sturivny/co2_temperature_sensor_mac/requirements-cad.txt

# CAD generators: Python 3.12+
numpy==2.5.4
manifold3d==3.5.4
trimesh==5.1.1
matplotlib==3.11.2
Pillow==12.3.0
