sturivny/co2_temperature_sensor_mac/docs/ru/HARDWARE.md

# Аппаратная часть и корпус

## Соединение

Подтверждённая распайка: **GND → GND, VDD → 3V3, SDA → GPIO5, SCL → GPIO6**.
Провода припаяны прямо к контактам, без гребёнок. OLED и датчик используют одну
шину. OLED найден на 0x3C, датчик — на 0x62. Контроллер питается через USB-C.
Не подменять GPIO номерами контактов и не ориентироваться на поворот фотографии.

Заказ был на модуль SCD40; позднее продавец прислал описание SCD41. Прошивка
использует общий периодический режим SCD4x. Точная модификация и паспортная
точность конкретного экземпляра отдельно не подтверждены.

При первом запуске обнаружилась ошибка взаимодействия U8g2 и уже работающей
шины Wire. Она исправлена в 0.1.1: перед display.begin() выполняется Wire.end(),
после инициализации аппаратный I²C снова подключён к контактам. Повторное
обнаружение OLED выполняется через пять секунд, если при старте он не ответил.

## Фактические размеры

| Деталь | Размер |
|---|---|
| PCB контроллера | 24,8 × 20,6 мм |
| Углы контроллера | приближённо срез 1 × 1 мм под 45° |
| PCB датчика | 22,2 × 13 мм |
| Толщина текстолита | 1,5 мм |
| Общая высота датчика | 8 мм |
| Общая высота контроллера по замеру | 4 мм |
| Выступ USB-C за PCB | 2 мм |
| Металл USB-C | 9 × 3 мм |
| Низ металла относительно низа PCB | 1,1 мм |
| Винты v0.9 | M2 × 10 мм из-под головки, внутренний шестигранник, головка снаружи |

Корпус v0.9: **78 × 40 × 17 мм**, углы R3, кромки R0,6, стенки/дно/крышка 2 мм.
Окно USB-C: капсула 9,6 × 3,6 мм, R1,8. Разъём рассчитан заподлицо с внешней
стенкой; опоры держат прямые участки PCB и не опираются на срезанные углы.
В крышке прямые отверстия Ø2,4 мм и плоская посадка под головки M2 с внутренним
шестигранником, без зенковки. Для M2×10 длина считается из-под головки.
Защёлки есть на пробных образцах; в полном корпусе плату удерживают опоры
и выступы крышки. Батарея и SD-карта не предусмотрены.

Пользователь подтвердил идеальную посадку последнего образца и начал печатать
полный корпус. Полная проверка температуры в закрытом корпусе, всех кабелей,
долговечности защёлок и конкретного power bank не проводилась.

Файлы печати и подробные инструкции: [enclosure/v0.8](ENCLOSURE-v09.md).

## Ориентиры по CO₂

Прибор измеряет CO₂, а не кислород. Для домашней вентиляции ориентир:
до 1000 ppm — хороший уровень; 1000–1500 — стоит проветрить;
1500–2000 — вентиляции недостаточно; выше 2000 — усилить проветривание.
Это ориентиры воздухообмена, а не границы отравления и не оценка всех загрязнений.
Смотреть на тенденцию, держать прибор дальше 0,5 м от лица и не прямо у окна.

Источники: [UBA](https://www.umweltbundesamt.de/sites/default/files/medien/pdfs/kohlendioxid_2008.pdf),
[HSE](https://www.hse.gov.uk/ventilation/using-co2-monitors.htm).
Протокол датчика: [Sensirion SCD4x datasheet](https://admin.sensirion.com/media/documents/48C4B7FB/64C134E7/Sensirion_SCD4x_Datasheet.pdf).
