sturivny/co2_temperature_sensor_mac/docs/ru/ENCLOSURE-v09.md

# Корпус v0.9 — усиленный упор, открытый паз и обычные винты

[English](../../enclosure/v0.9/README.md) · [Предыдущая версия v0.8](ENCLOSURE.md)

Что изменилось

## Изменения

Задний упор контроллера, который сломался при использовании, заменён широкой
стенкой **3,2 × 8 мм** вместо 1,65 × 4 мм. Добавлены опорная площадка **10 × 10 мм**,
соединённая с дном, и два косых ребра длиной **6 мм**, толщиной **1,8 мм**.
Рёбра заканчиваются до перегородки и не перекрывают канал проводов.
Положение контактной поверхности сохранено: зазор до платы **0,15 мм**.
Это усиление геометрии; реальную прочность и ресурс проверяем печатью.

В перегородке сделан **паз шириной 8 мм, открытый сверху до дна**. Теперь можно
припаять провода к обеим платам снаружи корпуса, установить платы и опустить
провода в паз. Продевать их через нижнее отверстие не требуется.
При закрывании не зажимать провода опорами плат или крышкой.

В крышке **прямые отверстия Ø2,4 мм и плоские площадки** под обычные винты M2
с внутренним шестигранником. Зенковки и углубления под головку нет: головки
остаются снаружи, их высота добавляется к высоте корпуса **17 мм**.
Для M2×10 длина **10 мм считается из-под головки**. При этой длине до дна
пилотного отверстия остаётся около 2 мм. Отверстия в стойках Ø1,7 мм остались
под ввинчивание в пластик. Реальную резьбу сначала проверить на образце винта.

## Что печатать

Файлы находятся в `enclosure/v0.9/`:

- **`base.stl` и `lid.stl`** — новые основание и крышка. Собранный корпус
  без головок винтов: **78 × 40 × 17 мм**. Для этой версии использовать оба файла.
- **`fit_esp32_snaps.stl`** — сначала проверить держатель контроллера:
  **37,8 × 24,6 × 15 мм**, с усиленным упором, защёлками и USB-стенкой.
- `fit_esp32.stl` — тот же образец без боковых защёлок.
- `screw_test_base.stl` и `screw_test_cap.stl` — маленькая проба винта и плоской посадки.
- Образцы датчика не изменились относительно v0.8; перепечатывать их не нужно.

Масштаб 100%, миллиметры. Основание и образцы печатать дном на стол.
Крышка в STL уже перевёрнута плоской внешней стороной на стол.
Начальные настройки: сопло 0,4 мм, слой 0,2 мм, четыре периметра, шесть нижних
слоёв. Не забивать поддержками прорези защёлок. Материал, межслойное сцепление,
усилие винта и долговечность требуют физической проверки.

Размеры плат, высота корпуса, окно экрана и положение USB сохранены.
В полном корпусе платы удерживаются опорами и выступами крышки; боковые защёлки
есть только на пробных образцах. Изгиб проводов и высота головок не моделировались.

## Проверки

Восемь STL повторно открыты: замкнутые сетки, согласованные грани, одно связное
тело. Проверены посадка плат, их установка сверху, снятие крышки, отсутствие
пересечений с принятыми габаритами компонентов, капсульное окно USB, плоская
посадка головок и открытый сверху проводной паз. Образцы датчика побайтно
совпадают с v0.8. Единственное удаление материала основания — открытие паза.

Площадь сечения упора возле дна увеличилась с 6,6 до 100 мм² благодаря площадке;
это **не коэффициент увеличения прочности**. Нагрузочные испытания и расчёт
на усталость не проводились. Сначала проверить новый держатель на печати.
Исходники и команды сборки: [English guide](../../enclosure/v0.9/README.md).
