sturivny/co2_temperature_sensor_mac/docs/ru/ENCLOSURE.md

# Корпус CO₂ — v0.8: контроллер у USB-стенки, опоры на прямых краях

## Исправления после реальной примерки

Пользователь сообщил: образец датчика подошёл идеально; у контроллера опоры не учитывали форму углов, а USB был слишком утоплен. Новый замер длины контроллера — **24,8 мм**, ширина остаётся **20,6 мм**. На фото углы скруглены, пользователь описал их примерно как срез 1 × 1 мм под 45°. Точный радиус не измерен.

В v0.8:

- Контроллер задан как 24,8 × 20,6 мм. Для изображения и проверки принят срез углов 1 × 1 мм; это приближение, не точный радиус с фотографии.
- Четыре нижние опоры перенесены под прямые длинные края. Начало площадок — в 2 мм от торцов, длина каждой 2 мм, заход под текстолит 0,8 мм. Уголки платы больше не являются опорными точками.
- Убраны продольные выступы упоров перед USB. Текстолит со стороны USB прилегает к внутренней поверхности стенки. Сзади есть отдельный упор посередине прямого торца, с зазором 0,15 мм.
- Внутренняя стенка корпуса расположена на x=76 мм, край PCB тоже на x=76 мм. Разъём выступает на 2 мм и заканчивается на внешней поверхности корпуса x=78 мм: **номинальное утопление USB равно нулю**. В пробном образце использована та же геометрия.
- Вместе с платой сдвинуты ответные выступы крышки и окно OLED. Боковые защёлки в пробном образце сохранены.
- Крепление датчика не менялось. Оба STL образца датчика побайтно совпадают с v0.7 — повторно печатать их не требуется.
- Крышка и стойки адаптированы к пользовательским винтам **2 × 10 мм с конусной головкой Ø4,6 мм**.

## Что печатать сначала

**`fit_esp32_snaps.stl` — новый образец контроллера с защёлками и USB-стенкой.** Его габарит 28,8 × 24,6 × 15 мм. Для проверки нового расположения платы достаточно этого файла. Не использовать старый образец v0.7.

При установке сориентировать USB к стенке, развести защёлки, опустить PCB на четыре площадки. Передний край текстолита должен подходить непосредственно к внутренней поверхности USB-стенки. После отпускания защёлок плата должна держаться без давления на экран или разъём. Проверить, что пластиковые опоры не попали под припой или отдельные компоненты. Они расположены на прямых краях, но точное положение всех элементов с фото не моделировалось.

Подключить реальный кабель и проверить полную посадку. В проекте убрано утопление разъёма; подтвердить это необходимо на печати. Если пластик мешает, не изгибать плату и не проталкивать штекер силой. Для снятия развести защёлки и поднять плату за текстолит.

Второй вариант `fit_esp32.stl` — те же новые нижние опоры и стенка, но без боковых защёлок.

## Размеры и форма корпуса

Полный корпус **78 × 40 × 17 мм**. Углы R3 мм, наружные горизонтальные кромки R0,6 мм. Дно 2 мм, нижняя поверхность PCB на высоте 5 мм, текстолит 1,5 мм. Крышка 2 мм, над принятым габаритом датчика остаётся 2 мм.

Окно USB-C — капсула **9,6 × 3,6 мм, концы R1,8 мм**. Размер металла — пользовательский 9 × 3 мм, зазор по контуру 0,3 мм. Нижний край металла на 1,1 мм выше нижней поверхности PCB: металл занимает высоты 6,1–9,1 мм, окно — 5,8–9,4 мм. Вертикальное положение окна сохранено, изменена только глубина установки платы. Стандартный профиль сверялся с USB-IF Figure 3-1; точная каталожная модель разъёма неизвестна.

Датчик: PCB 22,2 × 13 мм, общая высота 8 мм, металлическая часть 8 × 8 мм. Размеры и положение датчика сохранены. Высота контроллера и положения стекла взяты из прежних замеров; стекло 12 × 12 мм. Провода припаиваются прямо, гребёнки не устанавливаются. Батарея и SD не предусмотрены; питание от power bank, журнал планируется во flash ESP32 с выгрузкой на Mac. Прошивка и приложение реализованы в корне репозитория; см. основной README.

## Винты и зенковка

Приняты винты диаметром 2 мм, **полной длиной 10 мм вместе с потайной головкой**, диаметр головки 4,6 мм. Угол конуса принят **90°**, пользователь его не измерял. Зенковка в крышке имеет диаметр 4,8 мм, сквозное отверстие 2,4 мм. Конус глубиной 1,2 мм оставляет 0,8 мм материала до нижней поверхности крышки вокруг сквозного отверстия.

Пилотные отверстия в стойках: диаметр 1,7 мм, глубина 10 мм. При принятой геометрии головка садится примерно на 0,1 мм ниже поверхности крышки; между концом винта и дном пилотного отверстия остаётся около 1,9 мм. Расчёт основан на длине 10 мм включая головку и конусе 90°.

**Сначала проверить винт:** напечатать `screw_test_base.stl` и `screw_test_cap.stl`. Установить маленькую крышку на блок и вкрутить один свой винт вручную. Проверить, что конус садится, головка не торчит и винт стягивает детали, не раскалывая пластик и не упираясь в дно. Этот тест не требует электроники. Если 10 мм измерены без головки или конус отличается от 90°, длину отверстий/зенковку надо скорректировать по фактическому винту.

Отверстие 1,7 мм предполагает ввинчивание в пластик. Тип резьбы винта не установлен, гайки и резьбовые вставки не предусмотрены. Усилие и пригодность резьбы подтверждает только маленький тест. При заметном сопротивлении не затягивать сильнее, чтобы не сломать стойку.

## Печать

Масштаб 100%, миллиметры. Основание/образцы — дном на стол; крышка корпуса в STL уже перевёрнута для печати плоской внешней стороной на стол. Крышку образца винта печатать плоской нижней стороной на стол.

Стартовые настройки: сопло 0,4 мм, слой 0,2 мм, 3 периметра. Для защёлок предпочтителен PETG; PLA — для осторожной первичной примерки. Не заполнять поддержкой прорези гибких защёлок. Проверить в слайсере тонкие стенки, скосы и мост над USB. После печати прорези должны быть свободны, без слипания первого слоя.

Боковые защёлки по-прежнему находятся **только на пробных образцах**. В полном корпусе нижние опоры работают вместе с удерживающими выступами крышки. Их новые места также перенесены на прямые края. Провода и припой не должны попадать под опорные площадки и концы выступов.

## Файлы

- `fit_esp32_snaps.stl` — рекомендуемый новый образец контроллера.
- `fit_esp32.stl` — новый образец без защёлок.
- `base.stl`, `lid.stl` — обновлённый корпус, основание 78 × 40 × 15 мм, крышка в положении для печати 78 × 40 × 10,1 мм; суммарная высота корпуса 17 мм.
- `fit_sensor_snaps.stl`, `fit_sensor.stl` — сохранённые образцы датчика, перепечатывать не требуется.
- `screw_test_base.stl` — блок для винта 14 × 14 × 12 мм; `screw_test_cap.stl` — крышка с зенковкой 14 × 14 × 2 мм.
- `enclosure.scad`, SCAD образцов, `screw_test.scad` — геометрические исходники.
- `preview_controller.png` — образец контроллера пустой и с условной моделью платы; `preview.png` — корпус из STL; `preview_samples.png` — оба образца.
- `build_enclosure.py`, `build_samples.py`, `build_fastener_test.py` — генераторы (Python, numpy, manifold3d, trimesh, matplotlib, Pillow). STL созданы напрямую геометрическим ядром; SCAD отдельно в OpenSCAD не компилировался.
- `validation*.json` — проверки; `check_mount.py`, `check_usb_profile.py` — дополнительные проверки посадки и USB-профиля. Проверка неизменности датчика использует сохранённые контрольные суммы; соседняя папка v0.7 не нужна.

## Проверки и границы подтверждения

Все восемь STL повторно открыты после экспорта: замкнутые поверхности, согласованные грани, по одному связному телу. Пересечений основания/крышки и принятых габаритов PCB/компонентов нет. Проверены вертикальная установка идеализированной PCB и снятие крышки.

Суммарная площадь опирания контроллера на прямые края — 6,4 мм². Она сохраняется при условных срезах углов 1, 1,5 и 2 мм и при скруглении R2 мм. Это показывает независимость опор от формы уголков в этом диапазоне. Положение всех деталей и припоя не моделировалось.

В образце и корпусе номинальный торец USB находится на наружной поверхности стенки. Сечение отверстия повторно проверено непосредственно в STL. Геометрия образцов датчика идентична уже примеренной версии, но электрические измерения и работа в закрытом корпусе ещё не проверены. Физическая посадка контроллера, кабеля и винтов, упругость защёлок, усадка печати и резьба в пластике остаются на этапе пробной печати.

## Текущее подтверждение

После v0.8 пользователь подтвердил идеальную посадку образца и начал печать корпуса.
Датчик, OLED, USB, журнал и Wi-Fi затем проверены отдельно; детали в VALIDATION.md.
Прежние оговорки о физической посадке выше описывают этап разработки и не заменяют
это подтверждение. Проверка измерений внутри полностью собранного корпуса ещё не проведена.

## Воспроизведение

Из корня репозитория после установки requirements-cad.txt:

```bash
.tooling/venv/bin/python enclosure/v0.8/build_enclosure.py
.tooling/venv/bin/python enclosure/v0.8/build_samples.py
.tooling/venv/bin/python enclosure/v0.8/build_fastener_test.py
.tooling/venv/bin/python enclosure/v0.8/check_mount.py
.tooling/venv/bin/python enclosure/v0.8/check_usb_profile.py
```
