sturivny/co2_temperature_sensor_mac/enclosure/v0.9/preview_samples.png

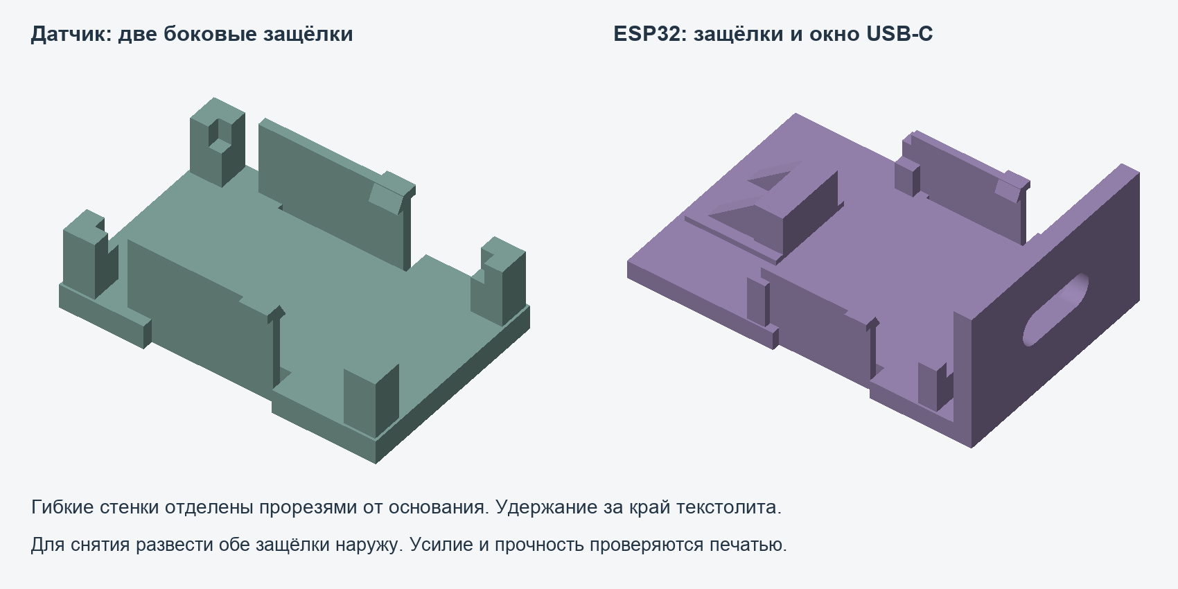
enclosure/v0.9/preview_samples.png
