sturivny/co2_temperature_sensor_mac/enclosure/v0.9/base.stl

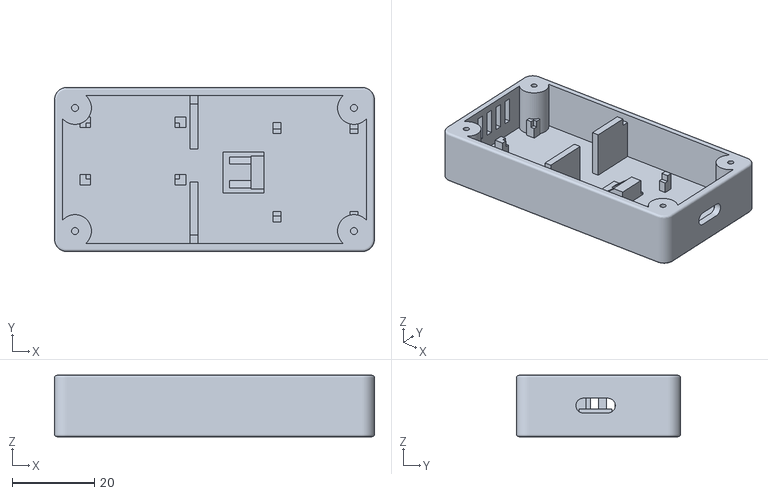
[picture p7: CAD file, 2026-10-28]
enclosure/v0.9/base.stl
78.0 x 40.0 x 15.0
