sturivny/co2_temperature_sensor_mac/enclosure/v0.9/fit_esp32_snaps.stl

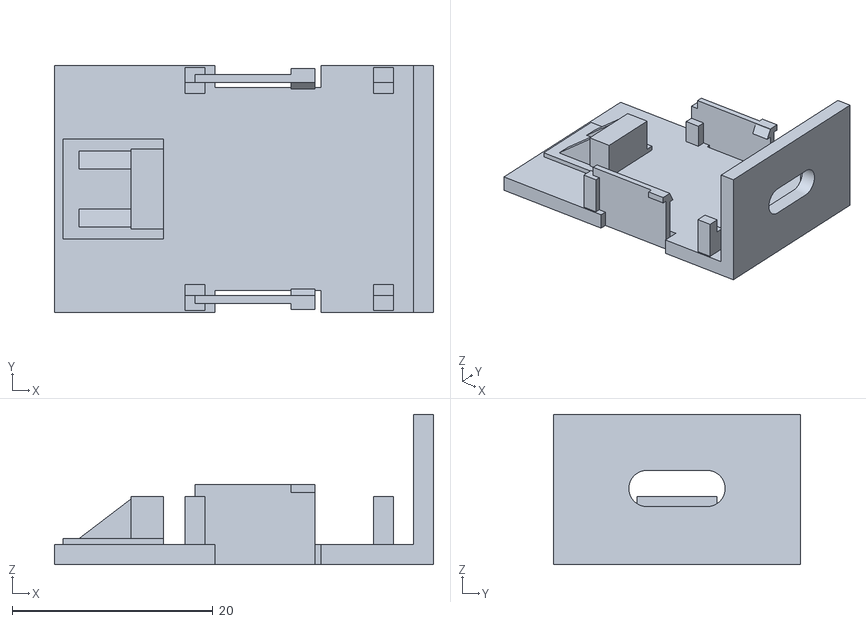
[picture p9: CAD file, 2026-10-28]
enclosure/v0.9/fit_esp32_snaps.stl
37.8 x 24.6 x 15.0
