sturivny/co2_temperature_sensor_mac/enclosure/v0.9/lid.stl

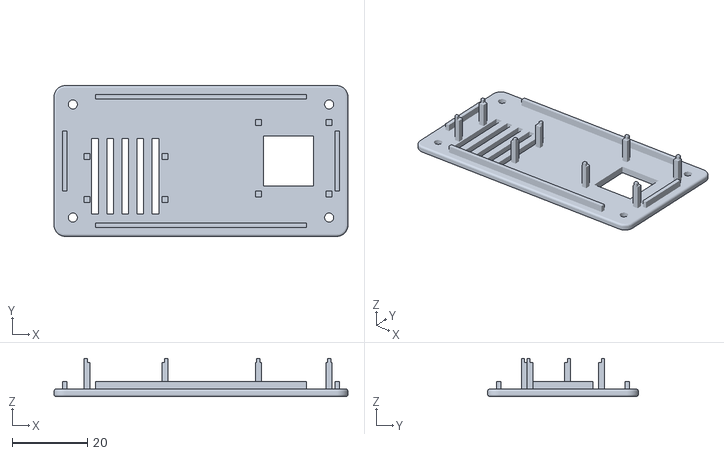
[picture p10: CAD file, 2026-10-28]
enclosure/v0.9/lid.stl
78.0 x 40.0 x 10.1
