sturivny/co2_temperature_sensor_mac/enclosure/v0.9/fit_sensor.stl

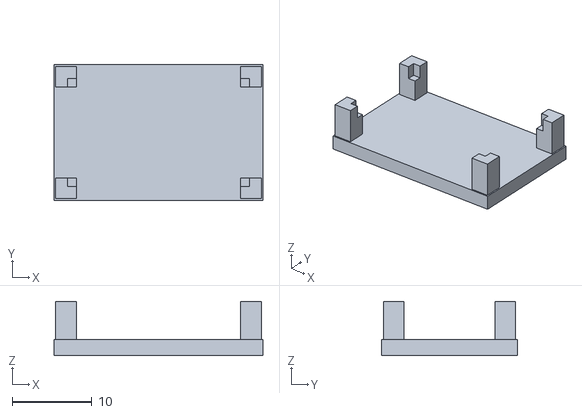
[picture p11: CAD file, 2026-10-16]
enclosure/v0.9/fit_sensor.stl
26.2 x 17.0 x 6.80
