sturivny/co2_temperature_sensor_mac/enclosure/v0.9/fit_sensor_snaps.stl

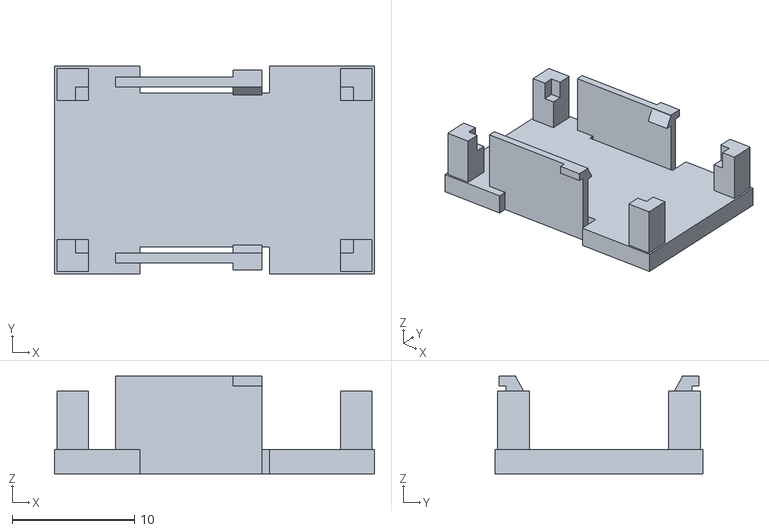
[picture p12: CAD file, 2026-10-16]
enclosure/v0.9/fit_sensor_snaps.stl
26.2 x 17.0 x 8.00
