sturivny/co2_temperature_sensor_mac/enclosure/v0.9/screw_test_cap.stl

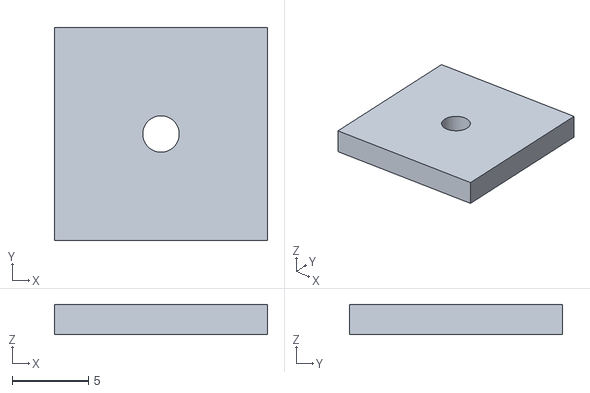
[picture p13: CAD file, 2026-10-28]
enclosure/v0.9/screw_test_cap.stl
14.0 x 14.0 x 2.00
