sturivny/co2_temperature_sensor_mac/enclosure/v0.9/screw_test_base.stl

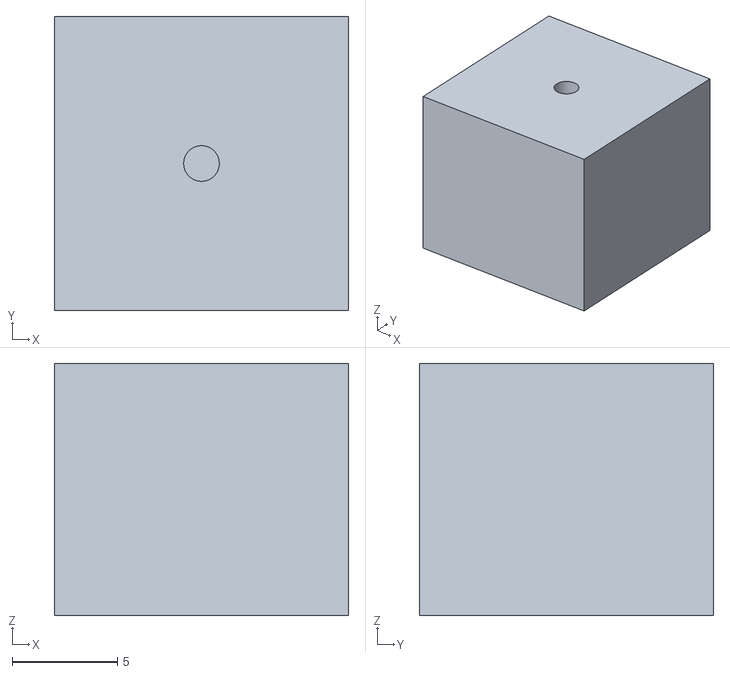
[picture p14: CAD file, 2026-10-16]
enclosure/v0.9/screw_test_base.stl
14.0 x 14.0 x 12.0
