sturivny/co2_temperature_sensor_mac/enclosure/v0.8/fit_esp32.stl

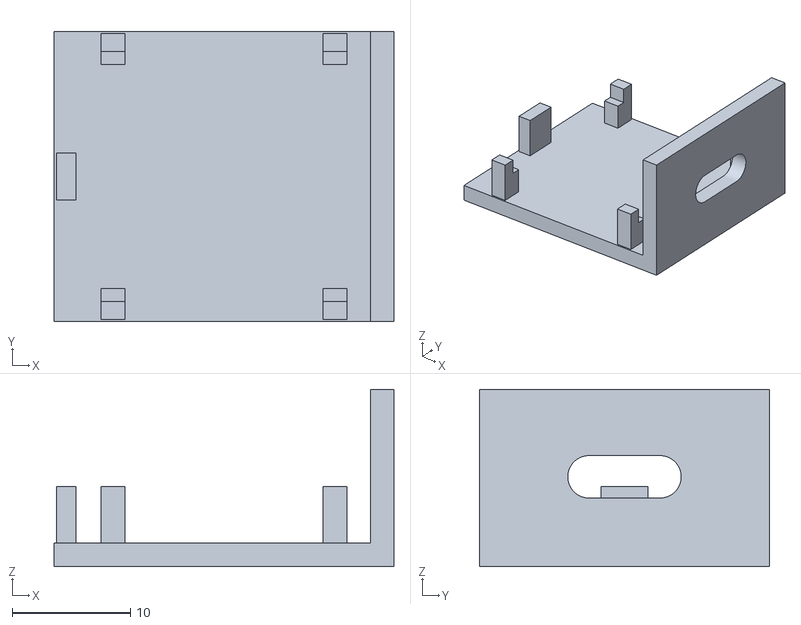
[picture p16: CAD file, 2026-10-16, an earlier design]
enclosure/v0.8/fit_esp32.stl
28.8 x 24.6 x 15.0
