sturivny/co2_temperature_sensor_mac/enclosure/v0.9/fit_sensor_snaps.scad

// Sample with flexible side latches, v0.9. Millimetres.
translate([-6.0, -16.0, 0]) union(){
difference(){
translate([6.0, 16.0, 0]) cube([26.2, 17.0, 2.0]);
translate([13.0, 15.9, -0.1]) cube([10.6, 2.3, 2.2]);
translate([13.0, 30.8, -0.1]) cube([10.6, 2.3, 2.2]);
}
union(){
translate([6.2, 16.2, 2.0]) cube([2.6, 2.6, 3.0]);
translate([6.2, 16.2, 2.0]) cube([1.5, 2.6, 4.8]);
translate([6.2, 16.2, 2.0]) cube([2.6, 1.5, 4.8]);
translate([6.2, 30.2, 2.0]) cube([2.6, 2.6, 3.0]);
translate([6.2, 30.2, 2.0]) cube([1.5, 2.6, 4.8]);
translate([6.2, 31.3, 2.0]) cube([2.6, 1.5, 4.8]);
translate([29.4, 16.2, 2.0]) cube([2.6, 2.6, 3.0]);
translate([30.5, 16.2, 2.0]) cube([1.5, 2.6, 4.8]);
translate([29.4, 16.2, 2.0]) cube([2.6, 1.5, 4.8]);
translate([29.4, 30.2, 2.0]) cube([2.6, 2.6, 3.0]);
translate([30.5, 30.2, 2.0]) cube([1.5, 2.6, 4.8]);
translate([29.4, 31.3, 2.0]) cube([2.6, 1.5, 4.8]);
}
union(){
translate([11.0, 16.9, 0]) cube([12.0, 0.8, 8.0]);
polyhedron(points=[[20.6, 18.35, 6.75], [23.0, 18.35, 6.75], [20.6, 17.65, 6.75], [23.0, 17.65, 6.75], [20.6, 17.65, 8.0], [23.0, 17.65, 8.0]],faces=[[0, 2, 4], [1, 5, 3], [0, 1, 3], [0, 3, 2], [2, 3, 5], [2, 5, 4], [4, 5, 1], [4, 1, 0]]);
translate([20.6, 16.299999999999997, 7.2]) cube([2.4, 0.65, 0.8]);
}
union(){
translate([11.0, 31.3, 0]) cube([12.0, 0.8, 8.0]);
polyhedron(points=[[20.6, 30.65, 6.75], [23.0, 30.65, 6.75], [20.6, 31.35, 6.75], [23.0, 31.35, 6.75], [20.6, 31.35, 8.0], [23.0, 31.35, 8.0]],faces=[[4, 2, 0], [3, 5, 1], [3, 1, 0], [2, 3, 0], [5, 3, 2], [4, 5, 2], [1, 5, 4], [0, 1, 4]]);
translate([20.6, 32.050000000000004, 7.2]) cube([2.4, 0.65, 0.8]);
}
}
