sturivny/co2_temperature_sensor_mac/enclosure/v0.9/enclosure.scad

// v0.9 measured boards; mm. Generated by build_enclosure.py.
// part: base / lid / assembly / exploded. STL lid is already oriented for printing.
part="exploded";
module base(){
difference(){
union(){
difference(){
polyhedron(points=[[77.4, 37.0, 0.0], [77.38844334401327, 37.23524113679095, 0.0], [77.35388467296775, 37.46821677283871, 0.0], [77.2966568057573, 37.69668322541071, 0.0], [77.21731087802709, 37.918440237676215, 0.0], [77.11661103443605, 38.13135216838239, 0.0], [76.9955270695261, 38.33336855924705, 0.0], [76.85522508807057, 38.522543881992746, 0.0], [76.69705627484771, 38.69705627484771, 0.0], [76.52254388199275, 38.85522508807057, 0.0], [76.33336855924705, 38.995527069526105, 0.0], [76.13135216838239, 39.116611034436055, 0.0], [75.91844023767622, 39.217310878027085, 0.0], [75.69668322541071, 39.2966568057573, 0.0], [75.4682167728387, 39.35388467296775, 0.0], [75.23524113679095, 39.388443344013275, 0.0], [75.0, 39.4, 0.0], [3.0, 39.4, 0.0], [2.7647588632090545, 39.388443344013275, 0.0], [2.5317832271612923, 39.35388467296775, 0.0], [2.30331677458929, 39.2966568057573, 0.0], [2.081559762323785, 39.217310878027085, 0.0], [1.8686478316176056, 39.116611034436055, 0.0], [1.6666314407529543, 38.995527069526105, 0.0], [1.4774561180072512, 38.85522508807057, 0.0], [1.3029437251522862, 38.69705627484771, 0.0], [1.1447749119294313, 38.522543881992746, 0.0], [1.0044729304738913, 38.33336855924705, 0.0], [0.8833889655639484, 38.13135216838239, 0.0], [0.7826891219729117, 37.918440237676215, 0.0], [0.7033431942426991, 37.69668322541071, 0.0], [0.646115327032247, 37.46821677283871, 0.0], [0.6115566559867278, 37.23524113679095, 0.0], [0.6000000000000001, 37.0, 0.0], [0.6000000000000001, 3.0000000000000004, 0.0], [0.6115566559867274, 2.7647588632090545, 0.0], [0.646115327032247, 2.531783227161292, 0.0], [0.7033431942426986, 2.303316774589291, 0.0], [0.7826891219729117, 2.081559762323785, 0.0], [0.883388965563948, 1.8686478316176056, 0.0], [1.0044729304738915, 1.6666314407529546, 0.0], [1.144774911929431, 1.4774561180072514, 0.0], [1.3029437251522855, 1.3029437251522862, 0.0], [1.47745611800725, 1.1447749119294321, 0.0], [1.6666314407529548, 1.0044729304738915, 0.0], [1.868647831617605, 0.8833889655639484, 0.0], [2.0815597623237854, 0.7826891219729117, 0.0], [2.30331677458929, 0.7033431942426991, 0.0], [2.5317832271612914, 0.6461153270322475, 0.0], [2.764758863209055, 0.6115566559867274, 0.0], [2.9999999999999996, 0.6000000000000001, 0.0], [75.0, 0.6000000000000001, 0.0], [75.23524113679095, 0.6115566559867274, 0.0], [75.4682167728387, 0.646115327032247, 0.0], [75.69668322541071, 0.7033431942426986, 0.0], [75.91844023767622, 0.7826891219729122, 0.0], [76.13135216838239, 0.883388965563948, 0.0], [76.33336855924705, 1.004472930473891, 0.0], [76.52254388199275, 1.1447749119294315, 0.0], [76.69705627484771, 1.3029437251522855, 0.0], [76.85522508807057, 1.4774561180072514, 0.0], [76.9955270695261, 1.6666314407529548, 0.0], [77.11661103443605, 1.868647831617605, 0.0], [77.21731087802709, 2.081559762323785, 0.0], [77.2966568057573, 2.30331677458929, 0.0], [77.35388467296775, 2.531783227161291, 0.0], [77.38844334401327, 2.764758863209055, 0.0], [77.4, 2.9999999999999996, 0.0], [77.55529142706152, 37.0, 0.020444504226559013], [77.54298700040802, 37.250462358389214, 0.020444504226559013], [77.5061922188025, 37.49851262735048, 0.020444504226559013], [77.44526143610588, 37.74176194719565, 0.020444504226559013], [77.3607814490637, 37.97786769400099, 0.020444504226559013], [77.2535658461326, 38.204556040356245, 0.020444504226559013], [77.12464717217885, 38.41964385356555, 0.020444504226559013], [76.97526698450673, 38.62105972040876, 0.020444504226559013], [76.80686389598304, 38.80686389598304, 0.020444504226559013], [76.62105972040877, 38.97526698450673, 0.020444504226559013], [76.41964385356556, 39.124647172178854, 0.020444504226559013], [76.20455604035624, 39.2535658461326, 0.020444504226559013], [75.97786769400099, 39.36078144906369, 0.020444504226559013], [75.74176194719564, 39.44526143610588, 0.020444504226559013], [75.49851262735048, 39.5061922188025, 0.020444504226559013], [75.25046235838921, 39.54298700040802, 0.020444504226559013], [75.0, 39.55529142706151, 0.020444504226559013], [3.0, 39.55529142706151, 0.020444504226559013], [2.7495376416107886, 39.54298700040802, 0.020444504226559013], [2.501487372649518, 39.5061922188025, 0.020444504226559013], [2.258238052804354, 39.44526143610588, 0.020444504226559013], [2.022132305999012, 39.36078144906369, 0.020444504226559013], [1.7954439596437561, 39.2535658461326, 0.020444504226559013], [1.5803561464344433, 39.124647172178854, 0.020444504226559013], [1.378940279591239, 38.97526698450673, 0.020444504226559013], [1.1931361040169546, 38.80686389598304, 0.020444504226559013], [1.0247330154932652, 38.62105972040876, 0.020444504226559013], [0.8753528278211467, 38.41964385356555, 0.020444504226559013], [0.7464341538673986, 38.204556040356245, 0.020444504226559013], [0.6392185509363113, 37.97786769400099, 0.020444504226559013], [0.5547385638941216, 37.74176194719565, 0.020444504226559013], [0.4938077811975039, 37.49851262735048, 0.020444504226559013], [0.45701299959198094, 37.250462358389214, 0.020444504226559013], [0.44470857293848765, 37.0, 0.020444504226559013], [0.44470857293848765, 3.0000000000000004, 0.020444504226559013], [0.45701299959198094, 2.7495376416107886, 0.020444504226559013], [0.4938077811975039, 2.5014873726495175, 0.020444504226559013], [0.5547385638941211, 2.258238052804355, 0.020444504226559013], [0.6392185509363109, 2.0221323059990124, 0.020444504226559013], [0.7464341538673986, 1.7954439596437564, 0.020444504226559013], [0.8753528278211467, 1.5803561464344436, 0.020444504226559013], [1.0247330154932648, 1.3789402795912393, 0.020444504226559013], [1.193136104016954, 1.1931361040169546, 0.020444504226559013], [1.378940279591238, 1.024733015493266, 0.020444504226559013], [1.5803561464344438, 0.8753528278211467, 0.020444504226559013], [1.7954439596437557, 0.7464341538673986, 0.020444504226559013], [2.022132305999013, 0.6392185509363109, 0.020444504226559013], [2.258238052804354, 0.5547385638941216, 0.020444504226559013], [2.5014873726495166, 0.4938077811975039, 0.020444504226559013], [2.749537641610789, 0.45701299959198094, 0.020444504226559013], [2.9999999999999996, 0.44470857293848765, 0.020444504226559013], [75.0, 0.44470857293848765, 0.020444504226559013], [75.25046235838921, 0.45701299959198094, 0.020444504226559013], [75.49851262735048, 0.4938077811975039, 0.020444504226559013], [75.74176194719564, 0.5547385638941211, 0.020444504226559013], [75.97786769400099, 0.6392185509363113, 0.020444504226559013], [76.20455604035624, 0.7464341538673986, 0.020444504226559013], [76.41964385356556, 0.8753528278211462, 0.020444504226559013], [76.62105972040877, 1.0247330154932655, 0.020444504226559013], [76.80686389598304, 1.193136104016954, 0.020444504226559013], [76.97526698450673, 1.3789402795912393, 0.020444504226559013], [77.12464717217885, 1.5803561464344438, 0.020444504226559013], [77.2535658461326, 1.7954439596437555, 0.020444504226559013], [77.3607814490637, 2.0221323059990124, 0.020444504226559013], [77.44526143610588, 2.258238052804354, 0.020444504226559013], [77.5061922188025, 2.5014873726495166, 0.020444504226559013], [77.54298700040802, 2.7495376416107886, 0.020444504226559013], [77.55529142706152, 2.9999999999999996, 0.020444504226559013], [77.7, 37.0, 0.08038475772933677], [77.68699876201494, 37.26464627888981, 0.08038475772933677], [77.64812025708872, 37.52674386944355, 0.08038475772933677], [77.58373890647697, 37.78376862858705, 0.08038475772933677], [77.49447473778048, 38.033245267385745, 0.08038475772933677], [77.38118741374056, 38.272771189430195, 0.08038475772933677], [77.24496795321687, 38.50003962915292, 0.08038475772933677], [77.0871282240794, 38.71286186724184, 0.08038475772933677], [76.90918830920369, 38.90918830920368, 0.08038475772933677], [76.71286186724184, 39.08712822407939, 0.08038475772933677], [76.50003962915292, 39.24496795321687, 0.08038475772933677], [76.27277118943019, 39.38118741374056, 0.08038475772933677], [76.03324526738574, 39.49447473778047, 0.08038475772933677], [75.78376862858705, 39.58373890647697, 0.08038475772933677], [75.52674386944355, 39.64812025708872, 0.08038475772933677], [75.26464627888981, 39.68699876201493, 0.08038475772933677], [75.0, 39.7, 0.08038475772933677], [3.0, 39.7, 0.08038475772933677], [2.735353721110186, 39.68699876201493, 0.08038475772933677], [2.4732561305564538, 39.64812025708872, 0.08038475772933677], [2.2162313714129516, 39.58373890647697, 0.08038475772933677], [1.9667547326142576, 39.49447473778047, 0.08038475772933677], [1.7272288105698061, 39.38118741374056, 0.08038475772933677], [1.4999603708470735, 39.24496795321687, 0.08038475772933677], [1.2871381327581575, 39.08712822407939, 0.08038475772933677], [1.0908116907963217, 38.90918830920368, 0.08038475772933677], [0.91287177592061, 38.71286186724184, 0.08038475772933677], [0.7550320467831275, 38.50003962915292, 0.08038475772933677], [0.6188125862594416, 38.272771189430195, 0.08038475772933677], [0.5055252622195257, 38.033245267385745, 0.08038475772933677], [0.416261093523036, 37.78376862858705, 0.08038475772933677], [0.35187974291127766, 37.52674386944354, 0.08038475772933677], [0.3130012379850684, 37.26464627888981, 0.08038475772933677], [0.2999999999999998, 37.0, 0.08038475772933677], [0.2999999999999998, 3.0000000000000004, 0.08038475772933677], [0.31300123798506796, 2.7353537211101866, 0.08038475772933677], [0.35187974291127766, 2.4732561305564533, 0.08038475772933677], [0.41626109352303553, 2.2162313714129525, 0.08038475772933677], [0.5055252622195252, 1.9667547326142578, 0.08038475772933677], [0.6188125862594411, 1.7272288105698064, 0.08038475772933677], [0.7550320467831275, 1.4999603708470737, 0.08038475772933677], [0.9128717759206095, 1.2871381327581577, 0.08038475772933677], [1.0908116907963212, 1.0908116907963217, 0.08038475772933677], [1.2871381327581561, 0.9128717759206109, 0.08038475772933677], [1.4999603708470741, 0.7550320467831275, 0.08038475772933677], [1.7272288105698055, 0.6188125862594416, 0.08038475772933677], [1.9667547326142583, 0.5055252622195252, 0.08038475772933677], [2.2162313714129516, 0.416261093523036, 0.08038475772933677], [2.4732561305564524, 0.3518797429112781, 0.08038475772933677], [2.7353537211101866, 0.31300123798506796, 0.08038475772933677], [2.9999999999999996, 0.2999999999999998, 0.08038475772933677], [75.0, 0.2999999999999998, 0.08038475772933677], [75.26464627888981, 0.31300123798506796, 0.08038475772933677], [75.52674386944355, 0.35187974291127766, 0.08038475772933677], [75.78376862858704, 0.41626109352303553, 0.08038475772933677], [76.03324526738574, 0.5055252622195261, 0.08038475772933677], [76.27277118943019, 0.6188125862594411, 0.08038475772933677], [76.50003962915292, 0.7550320467831271, 0.08038475772933677], [76.71286186724184, 0.9128717759206104, 0.08038475772933677], [76.90918830920367, 1.0908116907963212, 0.08038475772933677], [77.0871282240794, 1.2871381327581577, 0.08038475772933677], [77.24496795321687, 1.4999603708470741, 0.08038475772933677], [77.38118741374056, 1.7272288105698055, 0.08038475772933677], [77.49447473778048, 1.966754732614258, 0.08038475772933677], [77.58373890647697, 2.216231371412951, 0.08038475772933677], [77.64812025708872, 2.4732561305564524, 0.08038475772933677], [77.68699876201494, 2.7353537211101866, 0.08038475772933677], [77.7, 2.9999999999999996, 0.08038475772933677], [77.82426406871193, 37.0, 0.17573593128807144], [77.81066446527119, 37.276826287550676, 0.17573593128807144], [77.76999662656439, 37.550986586623594, 0.17573593128807144], [77.7026522061096, 37.819840583667414, 0.17573593128807144], [77.60927976749, 38.08079906772007, 0.17573593128807144], [77.49077853833205, 38.33134886592572, 0.17573593128807144], [77.34828975025192, 38.56907704676318, 0.17573593128807144], [77.18318564817109, 38.79169415789554, 0.17573593128807144], [76.99705627484771, 38.997056274847715, 0.17573593128807144], [76.79169415789553, 39.1831856481711, 0.17573593128807144], [76.56907704676317, 39.348289750251915, 0.17573593128807144], [76.33134886592572, 39.49077853833205, 0.17573593128807144], [76.08079906772008, 39.60927976749, 0.17573593128807144], [75.81984058366741, 39.702652206109605, 0.17573593128807144], [75.5509865866236, 39.7699966265644, 0.17573593128807144], [75.27682628755068, 39.81066446527119, 0.17573593128807144], [75.0, 39.824264068711926, 0.17573593128807144], [3.0, 39.824264068711926, 0.17573593128807144], [2.723173712449327, 39.81066446527119, 0.17573593128807144], [2.4490134133764094, 39.7699966265644, 0.17573593128807144], [2.1801594163325833, 39.702652206109605, 0.17573593128807144], [1.9192009322799255, 39.60927976749, 0.17573593128807144], [1.6686511340742816, 39.49077853833205, 0.17573593128807144], [1.4309229532368235, 39.348289750251915, 0.17573593128807144], [1.2083058421044603, 39.1831856481711, 0.17573593128807144], [1.0029437251522861, 38.997056274847715, 0.17573593128807144], [0.8168143518289042, 38.79169415789554, 0.17573593128807144], [0.6517102497480836, 38.56907704676318, 0.17573593128807144], [0.5092214616679467, 38.33134886592572, 0.17573593128807144], [0.39072023250999877, 38.08079906772007, 0.17573593128807144], [0.29734779389039323, 37.819840583667414, 0.17573593128807144], [0.23000337343560284, 37.55098658662359, 0.17573593128807144], [0.18933553472881304, 37.276826287550676, 0.17573593128807144], [0.17573593128807152, 37.0, 0.17573593128807144], [0.17573593128807152, 3.0000000000000004, 0.17573593128807144], [0.1893355347288126, 2.723173712449327, 0.17573593128807144], [0.23000337343560284, 2.449013413376409, 0.17573593128807144], [0.2973477938903928, 2.1801594163325837, 0.17573593128807144], [0.39072023250999877, 1.9192009322799257, 0.17573593128807144], [0.5092214616679467, 1.6686511340742818, 0.17573593128807144], [0.651710249748084, 1.430922953236824, 0.17573593128807144], [0.8168143518289037, 1.2083058421044606, 0.17573593128807144], [1.0029437251522855, 1.0029437251522861, 0.17573593128807144], [1.208305842104459, 0.816814351828905, 0.17573593128807144], [1.4309229532368242, 0.651710249748084, 0.17573593128807144], [1.668651134074281, 0.5092214616679467, 0.17573593128807144], [1.9192009322799262, 0.39072023250999877, 0.17573593128807144], [2.180159416332583, 0.29734779389039323, 0.17573593128807144], [2.449013413376408, 0.2300033734356033, 0.17573593128807144], [2.7231737124493276, 0.1893355347288126, 0.17573593128807144], [2.9999999999999996, 0.17573593128807152, 0.17573593128807144], [75.0, 0.17573593128807152, 0.17573593128807144], [75.27682628755068, 0.1893355347288126, 0.17573593128807144], [75.5509865866236, 0.23000337343560284, 0.17573593128807144], [75.81984058366741, 0.2973477938903928, 0.17573593128807144], [76.08079906772008, 0.3907202325099992, 0.17573593128807144], [76.33134886592572, 0.5092214616679467, 0.17573593128807144], [76.56907704676317, 0.6517102497480831, 0.17573593128807144], [76.79169415789553, 0.8168143518289042, 0.17573593128807144], [76.99705627484771, 1.0029437251522855, 0.17573593128807144], [77.18318564817109, 1.2083058421044606, 0.17573593128807144], [77.34828975025192, 1.4309229532368242, 0.17573593128807144], [77.49077853833205, 1.668651134074281, 0.17573593128807144], [77.60927976749, 1.9192009322799262, 0.17573593128807144], [77.7026522061096, 2.180159416332583, 0.17573593128807144], [77.76999662656439, 2.449013413376408, 0.17573593128807144], [77.81066446527119, 2.723173712449327, 0.17573593128807144], [77.82426406871193, 2.999999999999999, 0.17573593128807144], [77.91961524227067, 37.0, 0.29999999999999993], [77.9055564968671, 37.28617233690997, 0.29999999999999993], [77.86351565405998, 37.56958867777778, 0.29999999999999993], [77.79389759014737, 37.84751956830975, 0.29999999999999993], [77.69737276514185, 38.11728838209757, 0.29999999999999993], [77.57487076587407, 38.376297097993834, 0.29999999999999993], [77.4275713535634, 38.6220513204759, 0.29999999999999993], [77.2568931020724, 38.852184302038324, 0.29999999999999993], [77.06447973626518, 39.06447973626519, 0.29999999999999993], [76.85218430203832, 39.256893102072404, 0.29999999999999993], [76.62205132047589, 39.42757135356339, 0.29999999999999993], [76.37629709799384, 39.574870765874074, 0.29999999999999993], [76.11728838209757, 39.69737276514185, 0.29999999999999993], [75.84751956830975, 39.79389759014736, 0.29999999999999993], [75.56958867777779, 39.86351565405998, 0.29999999999999993], [75.28617233690997, 39.90555649686711, 0.29999999999999993], [75.0, 39.919615242270666, 0.29999999999999993], [3.0, 39.919615242270666, 0.29999999999999993], [2.713827663090032, 39.90555649686711, 0.29999999999999993], [2.43041132222222, 39.86351565405998, 0.29999999999999993], [2.1524804316902513, 39.79389759014736, 0.29999999999999993], [1.8827116179024295, 39.69737276514185, 0.29999999999999993], [1.6237029020061646, 39.574870765874074, 0.29999999999999993], [1.3779486795241047, 39.42757135356339, 0.29999999999999993], [1.1478156979616767, 39.256893102072404, 0.29999999999999993], [0.9355202637348095, 39.06447973626519, 0.29999999999999993], [0.7431068979275972, 38.852184302038324, 0.29999999999999993], [0.5724286464366095, 38.6220513204759, 0.29999999999999993], [0.42512923412592807, 38.376297097993834, 0.29999999999999993], [0.30262723485815224, 38.11728838209757, 0.29999999999999993], [0.20610240985263717, 37.84751956830975, 0.29999999999999993], [0.1364843459400218, 37.56958867777778, 0.29999999999999993], [0.09444350313289007, 37.28617233690997, 0.29999999999999993], [0.08038475772933662, 37.0, 0.29999999999999993], [0.08038475772933662, 3.0000000000000004, 0.29999999999999993], [0.09444350313288963, 2.7138276630900324, 0.29999999999999993], [0.1364843459400218, 2.43041132222222, 0.29999999999999993], [0.20610240985263673, 2.152480431690252, 0.29999999999999993], [0.30262723485815224, 1.8827116179024297, 0.29999999999999993], [0.4251292341259276, 1.6237029020061648, 0.29999999999999993], [0.57242864643661, 1.377948679524105, 0.29999999999999993], [0.7431068979275968, 1.147815697961677, 0.29999999999999993], [0.9355202637348086, 0.9355202637348095, 0.29999999999999993], [1.1478156979616754, 0.7431068979275981, 0.29999999999999993], [1.3779486795241054, 0.57242864643661, 0.29999999999999993], [1.623702902006164, 0.42512923412592807, 0.29999999999999993], [1.8827116179024301, 0.30262723485815224, 0.29999999999999993], [2.1524804316902513, 0.20610240985263717, 0.29999999999999993], [2.430411322222219, 0.13648434594002223, 0.29999999999999993], [2.713827663090033, 0.09444350313288963, 0.29999999999999993], [2.9999999999999996, 0.08038475772933662, 0.29999999999999993], [75.0, 0.08038475772933662, 0.29999999999999993], [75.28617233690997, 0.09444350313288963, 0.29999999999999993], [75.56958867777779, 0.1364843459400218, 0.29999999999999993], [75.84751956830975, 0.20610240985263673, 0.29999999999999993], [76.11728838209757, 0.3026272348581527, 0.29999999999999993], [76.37629709799384, 0.4251292341259276, 0.29999999999999993], [76.62205132047589, 0.5724286464366091, 0.29999999999999993], [76.85218430203832, 0.7431068979275977, 0.29999999999999993], [77.06447973626518, 0.9355202637348086, 0.29999999999999993], [77.2568931020724, 1.147815697961677, 0.29999999999999993], [77.4275713535634, 1.3779486795241054, 0.29999999999999993], [77.57487076587407, 1.6237029020061637, 0.29999999999999993], [77.69737276514185, 1.88271161790243, 0.29999999999999993], [77.79389759014737, 2.1524804316902513, 0.29999999999999993], [77.86351565405998, 2.4304113222222186, 0.29999999999999993], [77.9055564968671, 2.7138276630900324, 0.29999999999999993], [77.91961524227067, 2.999999999999999, 0.29999999999999993], [77.97955549577344, 37.0, 0.4447085729384874], [77.96520812166594, 37.29204750914894, 0.4447085729384874], [77.92230417239914, 37.581282441135365, 0.4447085729384874], [77.85125683645819, 37.864919305452354, 0.4447085729384874], [77.7527503385266, 38.14022652404485, 0.4447085729384874], [77.6277333500286, 38.404552737899564, 0.4447085729384874], [77.47740985290466, 38.65535234108169, 0.4447085729384874], [77.30322754460727, 38.890209996311555, 0.4447085729384874], [77.10686389598304, 39.10686389598305, 0.4447085729384874], [76.89020999631155, 39.30322754460726, 0.4447085729384874], [76.65535234108168, 39.477409852904664, 0.4447085729384874], [76.40455273789956, 39.627733350028606, 0.4447085729384874], [76.14022652404485, 39.7527503385266, 0.4447085729384874], [75.86491930545235, 39.851256836458184, 0.4447085729384874], [75.58128244113537, 39.92230417239914, 0.4447085729384874], [75.29204750914894, 39.96520812166593, 0.4447085729384874], [75.0, 39.97955549577344, 0.4447085729384874], [3.0, 39.97955549577344, 0.4447085729384874], [2.707952490851061, 39.96520812166593, 0.4447085729384874], [2.418717558864635, 39.92230417239914, 0.4447085729384874], [2.1350806945476473, 39.851256836458184, 0.4447085729384874], [1.859773475955153, 39.7527503385266, 0.4447085729384874], [1.595447262100432, 39.627733350028606, 0.4447085729384874], [1.3446476589183125, 39.47740985290466, 0.4447085729384874], [1.1097900036884483, 39.30322754460726, 0.4447085729384874], [0.8931361040169548, 39.10686389598305, 0.4447085729384874], [0.6967724553927379, 38.890209996311555, 0.4447085729384874], [0.5225901470953387, 38.65535234108169, 0.4447085729384874], [0.37226664997139736, 38.40455273789957, 0.4447085729384874], [0.24724966147339833, 38.14022652404485, 0.4447085729384874], [0.14874316354181571, 37.864919305452354, 0.4447085729384874], [0.07769582760085969, 37.581282441135365, 0.4447085729384874], [0.03479187833406616, 37.29204750914894, 0.4447085729384874], [0.02044450422655908, 37.0, 0.4447085729384874], [0.02044450422655908, 3.0000000000000004, 0.4447085729384874], [0.03479187833406616, 2.7079524908510613, 0.4447085729384874], [0.07769582760085969, 2.4187175588646346, 0.4447085729384874], [0.14874316354181527, 2.1350806945476477, 0.4447085729384874], [0.24724966147339789, 1.8597734759551532, 0.4447085729384874], [0.3722666499713969, 1.5954472621004323, 0.4447085729384874], [0.5225901470953391, 1.3446476589183127, 0.4447085729384874], [0.6967724553927375, 1.1097900036884485, 0.4447085729384874], [0.8931361040169539, 0.8931361040169548, 0.4447085729384874], [1.109790003688447, 0.6967724553927388, 0.4447085729384874], [1.3446476589183132, 0.5225901470953391, 0.4447085729384874], [1.5954472621004314, 0.37226664997139736, 0.4447085729384874], [1.8597734759551536, 0.24724966147339789, 0.4447085729384874], [2.135080694547647, 0.14874316354181571, 0.4447085729384874], [2.4187175588646337, 0.07769582760085969, 0.4447085729384874], [2.7079524908510617, 0.03479187833406616, 0.4447085729384874], [2.9999999999999996, 0.02044450422655908, 0.4447085729384874], [75.0, 0.02044450422655908, 0.4447085729384874], [75.29204750914894, 0.03479187833406616, 0.4447085729384874], [75.58128244113537, 0.07769582760085969, 0.4447085729384874], [75.86491930545235, 0.14874316354181527, 0.4447085729384874], [76.14022652404485, 0.24724966147339833, 0.4447085729384874], [76.40455273789956, 0.3722666499713969, 0.4447085729384874], [76.65535234108168, 0.5225901470953382, 0.4447085729384874], [76.89020999631155, 0.6967724553927384, 0.4447085729384874], [77.10686389598304, 0.8931361040169539, 0.4447085729384874], [77.30322754460727, 1.1097900036884485, 0.4447085729384874], [77.47740985290466, 1.3446476589183132, 0.4447085729384874], [77.6277333500286, 1.5954472621004314, 0.4447085729384874], [77.7527503385266, 1.8597734759551536, 0.4447085729384874], [77.85125683645819, 2.135080694547647, 0.4447085729384874], [77.92230417239914, 2.4187175588646332, 0.4447085729384874], [77.96520812166594, 2.7079524908510613, 0.4447085729384874], [77.97955549577344, 2.999999999999999, 0.4447085729384874], [78.0, 37.0, 0.5999999999999999], [77.98555418001659, 37.29405142098868, 0.5999999999999999], [77.94235584120969, 37.585270966048384, 0.5999999999999999], [77.87082100719662, 37.870854031763386, 0.5999999999999999], [77.77163859753387, 38.14805029709527, 0.5999999999999999], [77.64576379304506, 38.41419021047799, 0.5999999999999999], [77.49440883690764, 38.666710699058804, 0.5999999999999999], [77.31903136008822, 38.903179852490936, 0.5999999999999999], [77.12132034355965, 39.121320343559645, 0.5999999999999999], [76.90317985249094, 39.31903136008821, 0.5999999999999999], [76.66671069905881, 39.49440883690764, 0.5999999999999999], [76.414190210478, 39.64576379304506, 0.5999999999999999], [76.14805029709527, 39.77163859753386, 0.5999999999999999], [75.87085403176339, 39.870821007196625, 0.5999999999999999], [75.58527096604838, 39.94235584120969, 0.5999999999999999], [75.29405142098868, 39.98555418001659, 0.5999999999999999], [75.0, 40.0, 0.5999999999999999], [3.0, 40.0, 0.5999999999999999], [2.7059485790113182, 39.98555418001659, 0.5999999999999999], [2.414729033951615, 39.94235584120969, 0.5999999999999999], [2.129145968236613, 39.870821007196625, 0.5999999999999999], [1.8519497029047307, 39.77163859753386, 0.5999999999999999], [1.585809789522007, 39.64576379304506, 0.5999999999999999], [1.3332893009411928, 39.49440883690764, 0.5999999999999999], [1.0968201475090638, 39.31903136008821, 0.5999999999999999], [0.8786796564403576, 39.121320343559645, 0.5999999999999999], [0.6809686399117889, 38.903179852490936, 0.5999999999999999], [0.505591163092364, 38.666710699058804, 0.5999999999999999], [0.3542362069549352, 38.41419021047799, 0.5999999999999999], [0.22836140246614, 38.14805029709527, 0.5999999999999999], [0.1291789928033733, 37.870854031763386, 0.5999999999999999], [0.05764415879030871, 37.585270966048384, 0.5999999999999999], [0.014445819983409436, 37.29405142098868, 0.5999999999999999], [0.0, 37.0, 0.5999999999999999], [0.0, 3.0000000000000004, 0.5999999999999999], [0.014445819983409436, 2.7059485790113182, 0.5999999999999999], [0.05764415879030871, 2.414729033951615, 0.5999999999999999], [0.1291789928033733, 2.129145968236614, 0.5999999999999999], [0.22836140246613956, 1.851949702904731, 0.5999999999999999], [0.35423620695493474, 1.5858097895220071, 0.5999999999999999], [0.5055911630923644, 1.333289300941193, 0.5999999999999999], [0.6809686399117885, 1.0968201475090642, 0.5999999999999999], [0.8786796564403572, 0.8786796564403576, 0.5999999999999999], [1.0968201475090624, 0.6809686399117902, 0.5999999999999999], [1.3332893009411935, 0.5055911630923644, 0.5999999999999999], [1.5858097895220062, 0.3542362069549352, 0.5999999999999999], [1.8519497029047316, 0.22836140246613956, 0.5999999999999999], [2.129145968236613, 0.1291789928033733, 0.5999999999999999], [2.414729033951614, 0.05764415879030915, 0.5999999999999999], [2.7059485790113187, 0.014445819983409436, 0.5999999999999999], [2.9999999999999996, 0.0, 0.5999999999999999], [75.0, 0.0, 0.5999999999999999], [75.29405142098868, 0.014445819983409436, 0.5999999999999999], [75.58527096604838, 0.05764415879030871, 0.5999999999999999], [75.87085403176339, 0.1291789928033733, 0.5999999999999999], [76.14805029709527, 0.22836140246614, 0.5999999999999999], [76.414190210478, 0.35423620695493474, 0.5999999999999999], [76.66671069905881, 0.5055911630923635, 0.5999999999999999], [76.90317985249094, 0.6809686399117894, 0.5999999999999999], [77.12132034355965, 0.8786796564403572, 0.5999999999999999], [77.31903136008822, 1.0968201475090642, 0.5999999999999999], [77.49440883690764, 1.3332893009411935, 0.5999999999999999], [77.64576379304506, 1.585809789522006, 0.5999999999999999], [77.77163859753387, 1.8519497029047314, 0.5999999999999999], [77.87082100719662, 2.1291459682366125, 0.5999999999999999], [77.94235584120969, 2.414729033951614, 0.5999999999999999], [77.98555418001659, 2.7059485790113182, 0.5999999999999999], [78.0, 2.999999999999999, 0.5999999999999999], [78.0, 37.0, 14.4], [77.98555418001659, 37.29405142098868, 14.4], [77.94235584120969, 37.585270966048384, 14.4], [77.87082100719662, 37.870854031763386, 14.4], [77.77163859753387, 38.14805029709527, 14.4], [77.64576379304506, 38.41419021047799, 14.4], [77.49440883690764, 38.666710699058804, 14.4], [77.31903136008822, 38.903179852490936, 14.4], [77.12132034355965, 39.121320343559645, 14.4], [76.90317985249094, 39.31903136008821, 14.4], [76.66671069905881, 39.49440883690764, 14.4], [76.414190210478, 39.64576379304506, 14.4], [76.14805029709527, 39.77163859753386, 14.4], [75.87085403176339, 39.870821007196625, 14.4], [75.58527096604838, 39.94235584120969, 14.4], [75.29405142098868, 39.98555418001659, 14.4], [75.0, 40.0, 14.4], [3.0, 40.0, 14.4], [2.7059485790113182, 39.98555418001659, 14.4], [2.414729033951615, 39.94235584120969, 14.4], [2.129145968236613, 39.870821007196625, 14.4], [1.8519497029047307, 39.77163859753386, 14.4], [1.585809789522007, 39.64576379304506, 14.4], [1.3332893009411928, 39.49440883690764, 14.4], [1.0968201475090638, 39.31903136008821, 14.4], [0.8786796564403576, 39.121320343559645, 14.4], [0.6809686399117889, 38.903179852490936, 14.4], [0.505591163092364, 38.666710699058804, 14.4], [0.3542362069549352, 38.41419021047799, 14.4], [0.22836140246614, 38.14805029709527, 14.4], [0.1291789928033733, 37.870854031763386, 14.4], [0.05764415879030871, 37.585270966048384, 14.4], [0.014445819983409436, 37.29405142098868, 14.4], [0.0, 37.0, 14.4], [0.0, 3.0000000000000004, 14.4], [0.014445819983409436, 2.7059485790113182, 14.4], [0.05764415879030871, 2.414729033951615, 14.4], [0.1291789928033733, 2.129145968236614, 14.4], [0.22836140246613956, 1.851949702904731, 14.4], [0.35423620695493474, 1.5858097895220071, 14.4], [0.5055911630923644, 1.333289300941193, 14.4], [0.6809686399117885, 1.0968201475090642, 14.4], [0.8786796564403572, 0.8786796564403576, 14.4], [1.0968201475090624, 0.6809686399117902, 14.4], [1.3332893009411935, 0.5055911630923644, 14.4], [1.5858097895220062, 0.3542362069549352, 14.4], [1.8519497029047316, 0.22836140246613956, 14.4], [2.129145968236613, 0.1291789928033733, 14.4], [2.414729033951614, 0.05764415879030915, 14.4], [2.7059485790113187, 0.014445819983409436, 14.4], [2.9999999999999996, 0.0, 14.4], [75.0, 0.0, 14.4], [75.29405142098868, 0.014445819983409436, 14.4], [75.58527096604838, 0.05764415879030871, 14.4], [75.87085403176339, 0.1291789928033733, 14.4], [76.14805029709527, 0.22836140246614, 14.4], [76.414190210478, 0.35423620695493474, 14.4], [76.66671069905881, 0.5055911630923635, 14.4], [76.90317985249094, 0.6809686399117894, 14.4], [77.12132034355965, 0.8786796564403572, 14.4], [77.31903136008822, 1.0968201475090642, 14.4], [77.49440883690764, 1.3332893009411935, 14.4], [77.64576379304506, 1.585809789522006, 14.4], [77.77163859753387, 1.8519497029047314, 14.4], [77.87082100719662, 2.1291459682366125, 14.4], [77.94235584120969, 2.414729033951614, 14.4], [77.98555418001659, 2.7059485790113182, 14.4], [78.0, 2.999999999999999, 14.4], [77.97955549577344, 37.0, 14.555291427061512], [77.96520812166594, 37.29204750914894, 14.555291427061512], [77.92230417239914, 37.581282441135365, 14.555291427061512], [77.85125683645819, 37.864919305452354, 14.555291427061512], [77.7527503385266, 38.14022652404485, 14.555291427061512], [77.6277333500286, 38.404552737899564, 14.555291427061512], [77.47740985290466, 38.65535234108169, 14.555291427061512], [77.30322754460727, 38.890209996311555, 14.555291427061512], [77.10686389598304, 39.10686389598305, 14.555291427061512], [76.89020999631155, 39.30322754460726, 14.555291427061512], [76.65535234108168, 39.477409852904664, 14.555291427061512], [76.40455273789956, 39.627733350028606, 14.555291427061512], [76.14022652404485, 39.7527503385266, 14.555291427061512], [75.86491930545235, 39.851256836458184, 14.555291427061512], [75.58128244113537, 39.92230417239914, 14.555291427061512], [75.29204750914894, 39.96520812166593, 14.555291427061512], [75.0, 39.97955549577344, 14.555291427061512], [3.0, 39.97955549577344, 14.555291427061512], [2.707952490851061, 39.96520812166593, 14.555291427061512], [2.418717558864635, 39.92230417239914, 14.555291427061512], [2.1350806945476473, 39.851256836458184, 14.555291427061512], [1.859773475955153, 39.7527503385266, 14.555291427061512], [1.595447262100432, 39.627733350028606, 14.555291427061512], [1.3446476589183125, 39.47740985290466, 14.555291427061512], [1.1097900036884483, 39.30322754460726, 14.555291427061512], [0.8931361040169548, 39.10686389598305, 14.555291427061512], [0.6967724553927379, 38.890209996311555, 14.555291427061512], [0.5225901470953387, 38.65535234108169, 14.555291427061512], [0.37226664997139736, 38.40455273789957, 14.555291427061512], [0.24724966147339833, 38.14022652404485, 14.555291427061512], [0.14874316354181571, 37.864919305452354, 14.555291427061512], [0.07769582760085969, 37.581282441135365, 14.555291427061512], [0.03479187833406616, 37.29204750914894, 14.555291427061512], [0.02044450422655908, 37.0, 14.555291427061512], [0.02044450422655908, 3.0000000000000004, 14.555291427061512], [0.03479187833406616, 2.7079524908510613, 14.555291427061512], [0.07769582760085969, 2.4187175588646346, 14.555291427061512], [0.14874316354181527, 2.1350806945476477, 14.555291427061512], [0.24724966147339789, 1.8597734759551532, 14.555291427061512], [0.3722666499713969, 1.5954472621004323, 14.555291427061512], [0.5225901470953391, 1.3446476589183127, 14.555291427061512], [0.6967724553927375, 1.1097900036884485, 14.555291427061512], [0.8931361040169539, 0.8931361040169548, 14.555291427061512], [1.109790003688447, 0.6967724553927388, 14.555291427061512], [1.3446476589183132, 0.5225901470953391, 14.555291427061512], [1.5954472621004314, 0.37226664997139736, 14.555291427061512], [1.8597734759551536, 0.24724966147339789, 14.555291427061512], [2.135080694547647, 0.14874316354181571, 14.555291427061512], [2.4187175588646337, 0.07769582760085969, 14.555291427061512], [2.7079524908510617, 0.03479187833406616, 14.555291427061512], [2.9999999999999996, 0.02044450422655908, 14.555291427061512], [75.0, 0.02044450422655908, 14.555291427061512], [75.29204750914894, 0.03479187833406616, 14.555291427061512], [75.58128244113537, 0.07769582760085969, 14.555291427061512], [75.86491930545235, 0.14874316354181527, 14.555291427061512], [76.14022652404485, 0.24724966147339833, 14.555291427061512], [76.40455273789956, 0.3722666499713969, 14.555291427061512], [76.65535234108168, 0.5225901470953382, 14.555291427061512], [76.89020999631155, 0.6967724553927384, 14.555291427061512], [77.10686389598304, 0.8931361040169539, 14.555291427061512], [77.30322754460727, 1.1097900036884485, 14.555291427061512], [77.47740985290466, 1.3446476589183132, 14.555291427061512], [77.6277333500286, 1.5954472621004314, 14.555291427061512], [77.7527503385266, 1.8597734759551536, 14.555291427061512], [77.85125683645819, 2.135080694547647, 14.555291427061512], [77.92230417239914, 2.4187175588646332, 14.555291427061512], [77.96520812166594, 2.7079524908510613, 14.555291427061512], [77.97955549577344, 2.999999999999999, 14.555291427061512], [77.91961524227067, 37.0, 14.700000000000001], [77.9055564968671, 37.28617233690997, 14.700000000000001], [77.86351565405998, 37.56958867777778, 14.700000000000001], [77.79389759014737, 37.84751956830975, 14.700000000000001], [77.69737276514185, 38.11728838209757, 14.700000000000001], [77.57487076587407, 38.376297097993834, 14.700000000000001], [77.4275713535634, 38.6220513204759, 14.700000000000001], [77.2568931020724, 38.852184302038324, 14.700000000000001], [77.06447973626518, 39.06447973626519, 14.700000000000001], [76.85218430203832, 39.256893102072404, 14.700000000000001], [76.62205132047589, 39.42757135356339, 14.700000000000001], [76.37629709799384, 39.574870765874074, 14.700000000000001], [76.11728838209757, 39.69737276514185, 14.700000000000001], [75.84751956830975, 39.79389759014736, 14.700000000000001], [75.56958867777779, 39.86351565405998, 14.700000000000001], [75.28617233690997, 39.90555649686711, 14.700000000000001], [75.0, 39.919615242270666, 14.700000000000001], [3.0, 39.919615242270666, 14.700000000000001], [2.713827663090032, 39.90555649686711, 14.700000000000001], [2.43041132222222, 39.86351565405998, 14.700000000000001], [2.1524804316902513, 39.79389759014736, 14.700000000000001], [1.8827116179024295, 39.69737276514185, 14.700000000000001], [1.6237029020061646, 39.574870765874074, 14.700000000000001], [1.3779486795241047, 39.42757135356339, 14.700000000000001], [1.1478156979616767, 39.256893102072404, 14.700000000000001], [0.9355202637348095, 39.06447973626519, 14.700000000000001], [0.7431068979275972, 38.852184302038324, 14.700000000000001], [0.5724286464366095, 38.6220513204759, 14.700000000000001], [0.42512923412592807, 38.376297097993834, 14.700000000000001], [0.30262723485815224, 38.11728838209757, 14.700000000000001], [0.20610240985263717, 37.84751956830975, 14.700000000000001], [0.1364843459400218, 37.56958867777778, 14.700000000000001], [0.09444350313289007, 37.28617233690997, 14.700000000000001], [0.08038475772933662, 37.0, 14.700000000000001], [0.08038475772933662, 3.0000000000000004, 14.700000000000001], [0.09444350313288963, 2.7138276630900324, 14.700000000000001], [0.1364843459400218, 2.43041132222222, 14.700000000000001], [0.20610240985263673, 2.152480431690252, 14.700000000000001], [0.30262723485815224, 1.8827116179024297, 14.700000000000001], [0.4251292341259276, 1.6237029020061648, 14.700000000000001], [0.57242864643661, 1.377948679524105, 14.700000000000001], [0.7431068979275968, 1.147815697961677, 14.700000000000001], [0.9355202637348086, 0.9355202637348095, 14.700000000000001], [1.1478156979616754, 0.7431068979275981, 14.700000000000001], [1.3779486795241054, 0.57242864643661, 14.700000000000001], [1.623702902006164, 0.42512923412592807, 14.700000000000001], [1.8827116179024301, 0.30262723485815224, 14.700000000000001], [2.1524804316902513, 0.20610240985263717, 14.700000000000001], [2.430411322222219, 0.13648434594002223, 14.700000000000001], [2.713827663090033, 0.09444350313288963, 14.700000000000001], [2.9999999999999996, 0.08038475772933662, 14.700000000000001], [75.0, 0.08038475772933662, 14.700000000000001], [75.28617233690997, 0.09444350313288963, 14.700000000000001], [75.56958867777779, 0.1364843459400218, 14.700000000000001], [75.84751956830975, 0.20610240985263673, 14.700000000000001], [76.11728838209757, 0.3026272348581527, 14.700000000000001], [76.37629709799384, 0.4251292341259276, 14.700000000000001], [76.62205132047589, 0.5724286464366091, 14.700000000000001], [76.85218430203832, 0.7431068979275977, 14.700000000000001], [77.06447973626518, 0.9355202637348086, 14.700000000000001], [77.2568931020724, 1.147815697961677, 14.700000000000001], [77.4275713535634, 1.3779486795241054, 14.700000000000001], [77.57487076587407, 1.6237029020061637, 14.700000000000001], [77.69737276514185, 1.88271161790243, 14.700000000000001], [77.79389759014737, 2.1524804316902513, 14.700000000000001], [77.86351565405998, 2.4304113222222186, 14.700000000000001], [77.9055564968671, 2.7138276630900324, 14.700000000000001], [77.91961524227067, 2.999999999999999, 14.700000000000001], [77.82426406871193, 37.0, 14.824264068711928], [77.81066446527119, 37.276826287550676, 14.824264068711928], [77.76999662656439, 37.550986586623594, 14.824264068711928], [77.7026522061096, 37.819840583667414, 14.824264068711928], [77.60927976749, 38.08079906772007, 14.824264068711928], [77.49077853833205, 38.33134886592572, 14.824264068711928], [77.34828975025192, 38.56907704676318, 14.824264068711928], [77.18318564817109, 38.79169415789554, 14.824264068711928], [76.99705627484771, 38.997056274847715, 14.824264068711928], [76.79169415789553, 39.1831856481711, 14.824264068711928], [76.56907704676317, 39.348289750251915, 14.824264068711928], [76.33134886592572, 39.49077853833205, 14.824264068711928], [76.08079906772008, 39.60927976749, 14.824264068711928], [75.81984058366741, 39.702652206109605, 14.824264068711928], [75.5509865866236, 39.7699966265644, 14.824264068711928], [75.27682628755068, 39.81066446527119, 14.824264068711928], [75.0, 39.824264068711926, 14.824264068711928], [3.0, 39.824264068711926, 14.824264068711928], [2.723173712449327, 39.81066446527119, 14.824264068711928], [2.4490134133764094, 39.7699966265644, 14.824264068711928], [2.1801594163325833, 39.702652206109605, 14.824264068711928], [1.9192009322799255, 39.60927976749, 14.824264068711928], [1.6686511340742816, 39.49077853833205, 14.824264068711928], [1.4309229532368235, 39.348289750251915, 14.824264068711928], [1.2083058421044603, 39.1831856481711, 14.824264068711928], [1.0029437251522861, 38.997056274847715, 14.824264068711928], [0.8168143518289042, 38.79169415789554, 14.824264068711928], [0.6517102497480836, 38.56907704676318, 14.824264068711928], [0.5092214616679467, 38.33134886592572, 14.824264068711928], [0.39072023250999877, 38.08079906772007, 14.824264068711928], [0.29734779389039323, 37.819840583667414, 14.824264068711928], [0.23000337343560284, 37.55098658662359, 14.824264068711928], [0.18933553472881304, 37.276826287550676, 14.824264068711928], [0.17573593128807152, 37.0, 14.824264068711928], [0.17573593128807152, 3.0000000000000004, 14.824264068711928], [0.1893355347288126, 2.723173712449327, 14.824264068711928], [0.23000337343560284, 2.449013413376409, 14.824264068711928], [0.2973477938903928, 2.1801594163325837, 14.824264068711928], [0.39072023250999877, 1.9192009322799257, 14.824264068711928], [0.5092214616679467, 1.6686511340742818, 14.824264068711928], [0.651710249748084, 1.430922953236824, 14.824264068711928], [0.8168143518289037, 1.2083058421044606, 14.824264068711928], [1.0029437251522855, 1.0029437251522861, 14.824264068711928], [1.208305842104459, 0.816814351828905, 14.824264068711928], [1.4309229532368242, 0.651710249748084, 14.824264068711928], [1.668651134074281, 0.5092214616679467, 14.824264068711928], [1.9192009322799262, 0.39072023250999877, 14.824264068711928], [2.180159416332583, 0.29734779389039323, 14.824264068711928], [2.449013413376408, 0.2300033734356033, 14.824264068711928], [2.7231737124493276, 0.1893355347288126, 14.824264068711928], [2.9999999999999996, 0.17573593128807152, 14.824264068711928], [75.0, 0.17573593128807152, 14.824264068711928], [75.27682628755068, 0.1893355347288126, 14.824264068711928], [75.5509865866236, 0.23000337343560284, 14.824264068711928], [75.81984058366741, 0.2973477938903928, 14.824264068711928], [76.08079906772008, 0.3907202325099992, 14.824264068711928], [76.33134886592572, 0.5092214616679467, 14.824264068711928], [76.56907704676317, 0.6517102497480831, 14.824264068711928], [76.79169415789553, 0.8168143518289042, 14.824264068711928], [76.99705627484771, 1.0029437251522855, 14.824264068711928], [77.18318564817109, 1.2083058421044606, 14.824264068711928], [77.34828975025192, 1.4309229532368242, 14.824264068711928], [77.49077853833205, 1.668651134074281, 14.824264068711928], [77.60927976749, 1.9192009322799262, 14.824264068711928], [77.7026522061096, 2.180159416332583, 14.824264068711928], [77.76999662656439, 2.449013413376408, 14.824264068711928], [77.81066446527119, 2.723173712449327, 14.824264068711928], [77.82426406871193, 2.999999999999999, 14.824264068711928], [77.7, 37.0, 14.919615242270664], [77.68699876201494, 37.26464627888981, 14.919615242270664], [77.64812025708872, 37.52674386944355, 14.919615242270664], [77.58373890647697, 37.78376862858705, 14.919615242270664], [77.49447473778048, 38.033245267385745, 14.919615242270664], [77.38118741374056, 38.272771189430195, 14.919615242270664], [77.24496795321687, 38.50003962915292, 14.919615242270664], [77.0871282240794, 38.71286186724184, 14.919615242270664], [76.90918830920369, 38.90918830920368, 14.919615242270664], [76.71286186724184, 39.08712822407939, 14.919615242270664], [76.50003962915292, 39.24496795321687, 14.919615242270664], [76.27277118943019, 39.38118741374056, 14.919615242270664], [76.03324526738574, 39.49447473778047, 14.919615242270664], [75.78376862858705, 39.58373890647697, 14.919615242270664], [75.52674386944355, 39.64812025708872, 14.919615242270664], [75.26464627888981, 39.68699876201493, 14.919615242270664], [75.0, 39.7, 14.919615242270664], [3.0, 39.7, 14.919615242270664], [2.735353721110186, 39.68699876201493, 14.919615242270664], [2.4732561305564538, 39.64812025708872, 14.919615242270664], [2.2162313714129516, 39.58373890647697, 14.919615242270664], [1.9667547326142576, 39.49447473778047, 14.919615242270664], [1.7272288105698061, 39.38118741374056, 14.919615242270664], [1.4999603708470735, 39.24496795321687, 14.919615242270664], [1.2871381327581575, 39.08712822407939, 14.919615242270664], [1.0908116907963217, 38.90918830920368, 14.919615242270664], [0.91287177592061, 38.71286186724184, 14.919615242270664], [0.7550320467831275, 38.50003962915292, 14.919615242270664], [0.6188125862594416, 38.272771189430195, 14.919615242270664], [0.5055252622195257, 38.033245267385745, 14.919615242270664], [0.416261093523036, 37.78376862858705, 14.919615242270664], [0.35187974291127766, 37.52674386944354, 14.919615242270664], [0.3130012379850684, 37.26464627888981, 14.919615242270664], [0.2999999999999998, 37.0, 14.919615242270664], [0.2999999999999998, 3.0000000000000004, 14.919615242270664], [0.31300123798506796, 2.7353537211101866, 14.919615242270664], [0.35187974291127766, 2.4732561305564533, 14.919615242270664], [0.41626109352303553, 2.2162313714129525, 14.919615242270664], [0.5055252622195252, 1.9667547326142578, 14.919615242270664], [0.6188125862594411, 1.7272288105698064, 14.919615242270664], [0.7550320467831275, 1.4999603708470737, 14.919615242270664], [0.9128717759206095, 1.2871381327581577, 14.919615242270664], [1.0908116907963212, 1.0908116907963217, 14.919615242270664], [1.2871381327581561, 0.9128717759206109, 14.919615242270664], [1.4999603708470741, 0.7550320467831275, 14.919615242270664], [1.7272288105698055, 0.6188125862594416, 14.919615242270664], [1.9667547326142583, 0.5055252622195252, 14.919615242270664], [2.2162313714129516, 0.416261093523036, 14.919615242270664], [2.4732561305564524, 0.3518797429112781, 14.919615242270664], [2.7353537211101866, 0.31300123798506796, 14.919615242270664], [2.9999999999999996, 0.2999999999999998, 14.919615242270664], [75.0, 0.2999999999999998, 14.919615242270664], [75.26464627888981, 0.31300123798506796, 14.919615242270664], [75.52674386944355, 0.35187974291127766, 14.919615242270664], [75.78376862858704, 0.41626109352303553, 14.919615242270664], [76.03324526738574, 0.5055252622195261, 14.919615242270664], [76.27277118943019, 0.6188125862594411, 14.919615242270664], [76.50003962915292, 0.7550320467831271, 14.919615242270664], [76.71286186724184, 0.9128717759206104, 14.919615242270664], [76.90918830920367, 1.0908116907963212, 14.919615242270664], [77.0871282240794, 1.2871381327581577, 14.919615242270664], [77.24496795321687, 1.4999603708470741, 14.919615242270664], [77.38118741374056, 1.7272288105698055, 14.919615242270664], [77.49447473778048, 1.966754732614258, 14.919615242270664], [77.58373890647697, 2.216231371412951, 14.919615242270664], [77.64812025708872, 2.4732561305564524, 14.919615242270664], [77.68699876201494, 2.7353537211101866, 14.919615242270664], [77.7, 2.9999999999999996, 14.919615242270664], [77.55529142706152, 37.0, 14.979555495773441], [77.54298700040802, 37.250462358389214, 14.979555495773441], [77.5061922188025, 37.49851262735048, 14.979555495773441], [77.44526143610588, 37.74176194719565, 14.979555495773441], [77.3607814490637, 37.97786769400099, 14.979555495773441], [77.2535658461326, 38.204556040356245, 14.979555495773441], [77.12464717217885, 38.41964385356555, 14.979555495773441], [76.97526698450673, 38.62105972040876, 14.979555495773441], [76.80686389598304, 38.80686389598304, 14.979555495773441], [76.62105972040877, 38.97526698450673, 14.979555495773441], [76.41964385356556, 39.124647172178854, 14.979555495773441], [76.20455604035624, 39.2535658461326, 14.979555495773441], [75.97786769400099, 39.36078144906369, 14.979555495773441], [75.74176194719564, 39.44526143610588, 14.979555495773441], [75.49851262735048, 39.5061922188025, 14.979555495773441], [75.25046235838921, 39.54298700040802, 14.979555495773441], [75.0, 39.55529142706151, 14.979555495773441], [3.0, 39.55529142706151, 14.979555495773441], [2.7495376416107886, 39.54298700040802, 14.979555495773441], [2.5014873726495175, 39.5061922188025, 14.979555495773441], [2.258238052804354, 39.44526143610588, 14.979555495773441], [2.022132305999012, 39.36078144906369, 14.979555495773441], [1.795443959643756, 39.2535658461326, 14.979555495773441], [1.5803561464344429, 39.124647172178854, 14.979555495773441], [1.3789402795912389, 38.97526698450674, 14.979555495773441], [1.1931361040169544, 38.80686389598305, 14.979555495773441], [1.0247330154932648, 38.62105972040876, 14.979555495773441], [0.8753528278211462, 38.41964385356555, 14.979555495773441], [0.7464341538673986, 38.204556040356245, 14.979555495773441], [0.6392185509363109, 37.97786769400099, 14.979555495773441], [0.5547385638941211, 37.74176194719565, 14.979555495773441], [0.49380778119750346, 37.49851262735048, 14.979555495773441], [0.4570129995919805, 37.250462358389214, 14.979555495773441], [0.4447085729384872, 37.0, 14.979555495773441], [0.4447085729384872, 3.0000000000000004, 14.979555495773441], [0.4570129995919805, 2.7495376416107886, 14.979555495773441], [0.49380778119750346, 2.5014873726495175, 14.979555495773441], [0.5547385638941207, 2.258238052804355, 14.979555495773441], [0.6392185509363104, 2.022132305999012, 14.979555495773441], [0.7464341538673982, 1.7954439596437561, 14.979555495773441], [0.8753528278211462, 1.5803561464344433, 14.979555495773441], [1.0247330154932646, 1.378940279591239, 14.979555495773441], [1.1931361040169537, 1.1931361040169544, 14.979555495773441], [1.3789402795912378, 1.0247330154932657, 14.979555495773441], [1.5803561464344436, 0.8753528278211462, 14.979555495773441], [1.7954439596437555, 0.7464341538673986, 14.979555495773441], [2.0221323059990124, 0.6392185509363104, 14.979555495773441], [2.258238052804354, 0.5547385638941211, 14.979555495773441], [2.5014873726495166, 0.49380778119750346, 14.979555495773441], [2.749537641610789, 0.4570129995919805, 14.979555495773441], [2.9999999999999996, 0.4447085729384872, 14.979555495773441], [75.0, 0.4447085729384872, 14.979555495773441], [75.25046235838921, 0.4570129995919805, 14.979555495773441], [75.49851262735048, 0.49380778119750346, 14.979555495773441], [75.74176194719564, 0.5547385638941207, 14.979555495773441], [75.97786769400099, 0.6392185509363113, 14.979555495773441], [76.20455604035624, 0.7464341538673982, 14.979555495773441], [76.41964385356556, 0.8753528278211458, 14.979555495773441], [76.62105972040877, 1.024733015493265, 14.979555495773441], [76.80686389598304, 1.1931361040169537, 14.979555495773441], [76.97526698450673, 1.378940279591239, 14.979555495773441], [77.12464717217885, 1.5803561464344436, 14.979555495773441], [77.2535658461326, 1.7954439596437552, 14.979555495773441], [77.3607814490637, 2.0221323059990124, 14.979555495773441], [77.44526143610588, 2.2582380528043537, 14.979555495773441], [77.5061922188025, 2.5014873726495166, 14.979555495773441], [77.54298700040802, 2.7495376416107886, 14.979555495773441], [77.55529142706152, 2.9999999999999996, 14.979555495773441], [77.4, 37.0, 15.0], [77.38844334401327, 37.23524113679095, 15.0], [77.35388467296775, 37.46821677283871, 15.0], [77.2966568057573, 37.69668322541071, 15.0], [77.21731087802709, 37.918440237676215, 15.0], [77.11661103443605, 38.13135216838239, 15.0], [76.9955270695261, 38.33336855924705, 15.0], [76.85522508807057, 38.522543881992746, 15.0], [76.69705627484771, 38.69705627484771, 15.0], [76.52254388199275, 38.85522508807057, 15.0], [76.33336855924705, 38.99552706952611, 15.0], [76.13135216838239, 39.116611034436055, 15.0], [75.91844023767622, 39.21731087802709, 15.0], [75.69668322541071, 39.2966568057573, 15.0], [75.4682167728387, 39.35388467296775, 15.0], [75.23524113679095, 39.388443344013275, 15.0], [75.0, 39.4, 15.0], [3.0, 39.4, 15.0], [2.7647588632090545, 39.388443344013275, 15.0], [2.5317832271612923, 39.35388467296775, 15.0], [2.30331677458929, 39.2966568057573, 15.0], [2.0815597623237845, 39.21731087802709, 15.0], [1.8686478316176054, 39.116611034436055, 15.0], [1.666631440752954, 38.99552706952611, 15.0], [1.477456118007251, 38.85522508807057, 15.0], [1.3029437251522857, 38.69705627484772, 15.0], [1.144774911929431, 38.522543881992746, 15.0], [1.0044729304738909, 38.33336855924705, 15.0], [0.883388965563948, 38.13135216838239, 15.0], [0.7826891219729113, 37.918440237676215, 15.0], [0.7033431942426986, 37.69668322541071, 15.0], [0.6461153270322466, 37.46821677283871, 15.0], [0.6115566559867274, 37.23524113679095, 15.0], [0.5999999999999996, 37.0, 15.0], [0.5999999999999996, 3.0000000000000004, 15.0], [0.6115566559867269, 2.7647588632090545, 15.0], [0.6461153270322466, 2.531783227161292, 15.0], [0.7033431942426982, 2.303316774589291, 15.0], [0.7826891219729113, 2.081559762323785, 15.0], [0.8833889655639475, 1.8686478316176054, 15.0], [1.004472930473891, 1.6666314407529543, 15.0], [1.1447749119294306, 1.4774561180072512, 15.0], [1.3029437251522853, 1.3029437251522857, 15.0], [1.4774561180072499, 1.1447749119294317, 15.0], [1.6666314407529546, 1.004472930473891, 15.0], [1.8686478316176047, 0.883388965563948, 15.0], [2.081559762323785, 0.7826891219729113, 15.0], [2.30331677458929, 0.7033431942426986, 15.0], [2.531783227161291, 0.646115327032247, 15.0], [2.764758863209055, 0.6115566559867269, 15.0], [2.9999999999999996, 0.5999999999999996, 15.0], [75.0, 0.5999999999999996, 15.0], [75.23524113679095, 0.6115566559867269, 15.0], [75.4682167728387, 0.6461153270322466, 15.0], [75.69668322541071, 0.7033431942426982, 15.0], [75.91844023767622, 0.7826891219729117, 15.0], [76.13135216838239, 0.8833889655639475, 15.0], [76.33336855924705, 1.0044729304738906, 15.0], [76.52254388199275, 1.1447749119294313, 15.0], [76.69705627484771, 1.3029437251522853, 15.0], [76.85522508807057, 1.4774561180072512, 15.0], [76.9955270695261, 1.6666314407529546, 15.0], [77.11661103443605, 1.8686478316176047, 15.0], [77.21731087802709, 2.081559762323785, 15.0], [77.2966568057573, 2.3033167745892897, 15.0], [77.35388467296775, 2.531783227161291, 15.0], [77.38844334401327, 2.764758863209055, 15.0], [77.4, 2.9999999999999996, 15.0], [39.0, 20.0, 0.0], [39.0, 20.0, 15.0]],faces=[[0, 1, 69], [0, 69, 68], [1, 2, 70], [1, 70, 69], [2, 3, 71], [2, 71, 70], [3, 4, 72], [3, 72, 71], [4, 5, 73], [4, 73, 72], [5, 6, 74], [5, 74, 73], [6, 7, 75], [6, 75, 74], [7, 8, 76], [7, 76, 75], [8, 9, 77], [8, 77, 76], [9, 10, 78], [9, 78, 77], [10, 11, 79], [10, 79, 78], [11, 12, 80], [11, 80, 79], [12, 13, 81], [12, 81, 80], [13, 14, 82], [13, 82, 81], [14, 15, 83], [14, 83, 82], [15, 16, 84], [15, 84, 83], [16, 17, 85], [16, 85, 84], [17, 18, 86], [17, 86, 85], [18, 19, 87], [18, 87, 86], [19, 20, 88], [19, 88, 87], [20, 21, 89], [20, 89, 88], [21, 22, 90], [21, 90, 89], [22, 23, 91], [22, 91, 90], [23, 24, 92], [23, 92, 91], [24, 25, 93], [24, 93, 92], [25, 26, 94], [25, 94, 93], [26, 27, 95], [26, 95, 94], [27, 28, 96], [27, 96, 95], [28, 29, 97], [28, 97, 96], [29, 30, 98], [29, 98, 97], [30, 31, 99], [30, 99, 98], [31, 32, 100], [31, 100, 99], [32, 33, 101], [32, 101, 100], [33, 34, 102], [33, 102, 101], [34, 35, 103], [34, 103, 102], [35, 36, 104], [35, 104, 103], [36, 37, 105], [36, 105, 104], [37, 38, 106], [37, 106, 105], [38, 39, 107], [38, 107, 106], [39, 40, 108], [39, 108, 107], [40, 41, 109], [40, 109, 108], [41, 42, 110], [41, 110, 109], [42, 43, 111], [42, 111, 110], [43, 44, 112], [43, 112, 111], [44, 45, 113], [44, 113, 112], [45, 46, 114], [45, 114, 113], [46, 47, 115], [46, 115, 114], [47, 48, 116], [47, 116, 115], [48, 49, 117], [48, 117, 116], [49, 50, 118], [49, 118, 117], [50, 51, 119], [50, 119, 118], [51, 52, 120], [51, 120, 119], [52, 53, 121], [52, 121, 120], [53, 54, 122], [53, 122, 121], [54, 55, 123], [54, 123, 122], [55, 56, 124], [55, 124, 123], [56, 57, 125], [56, 125, 124], [57, 58, 126], [57, 126, 125], [58, 59, 127], [58, 127, 126], [59, 60, 128], [59, 128, 127], [60, 61, 129], [60, 129, 128], [61, 62, 130], [61, 130, 129], [62, 63, 131], [62, 131, 130], [63, 64, 132], [63, 132, 131], [64, 65, 133], [64, 133, 132], [65, 66, 134], [65, 134, 133], [66, 67, 135], [66, 135, 134], [67, 0, 68], [67, 68, 135], [68, 69, 137], [68, 137, 136], [69, 70, 138], [69, 138, 137], [70, 71, 139], [70, 139, 138], [71, 72, 140], [71, 140, 139], [72, 73, 141], [72, 141, 140], [73, 74, 142], [73, 142, 141], [74, 75, 143], [74, 143, 142], [75, 76, 144], [75, 144, 143], [76, 77, 145], [76, 145, 144], [77, 78, 146], [77, 146, 145], [78, 79, 147], [78, 147, 146], [79, 80, 148], [79, 148, 147], [80, 81, 149], [80, 149, 148], [81, 82, 150], [81, 150, 149], [82, 83, 151], [82, 151, 150], [83, 84, 152], [83, 152, 151], [84, 85, 153], [84, 153, 152], [85, 86, 154], [85, 154, 153], [86, 87, 155], [86, 155, 154], [87, 88, 156], [87, 156, 155], [88, 89, 157], [88, 157, 156], [89, 90, 158], [89, 158, 157], [90, 91, 159], [90, 159, 158], [91, 92, 160], [91, 160, 159], [92, 93, 161], [92, 161, 160], [93, 94, 162], [93, 162, 161], [94, 95, 163], [94, 163, 162], [95, 96, 164], [95, 164, 163], [96, 97, 165], [96, 165, 164], [97, 98, 166], [97, 166, 165], [98, 99, 167], [98, 167, 166], [99, 100, 168], [99, 168, 167], [100, 101, 169], [100, 169, 168], [101, 102, 170], [101, 170, 169], [102, 103, 171], [102, 171, 170], [103, 104, 172], [103, 172, 171], [104, 105, 173], [104, 173, 172], [105, 106, 174], [105, 174, 173], [106, 107, 175], [106, 175, 174], [107, 108, 176], [107, 176, 175], [108, 109, 177], [108, 177, 176], [109, 110, 178], [109, 178, 177], [110, 111, 179], [110, 179, 178], [111, 112, 180], [111, 180, 179], [112, 113, 181], [112, 181, 180], [113, 114, 182], [113, 182, 181], [114, 115, 183], [114, 183, 182], [115, 116, 184], [115, 184, 183], [116, 117, 185], [116, 185, 184], [117, 118, 186], [117, 186, 185], [118, 119, 187], [118, 187, 186], [119, 120, 188], [119, 188, 187], [120, 121, 189], [120, 189, 188], [121, 122, 190], [121, 190, 189], [122, 123, 191], [122, 191, 190], [123, 124, 192], [123, 192, 191], [124, 125, 193], [124, 193, 192], [125, 126, 194], [125, 194, 193], [126, 127, 195], [126, 195, 194], [127, 128, 196], [127, 196, 195], [128, 129, 197], [128, 197, 196], [129, 130, 198], [129, 198, 197], [130, 131, 199], [130, 199, 198], [131, 132, 200], [131, 200, 199], [132, 133, 201], [132, 201, 200], [133, 134, 202], [133, 202, 201], [134, 135, 203], [134, 203, 202], [135, 68, 136], [135, 136, 203], [136, 137, 205], [136, 205, 204], [137, 138, 206], [137, 206, 205], [138, 139, 207], [138, 207, 206], [139, 140, 208], [139, 208, 207], [140, 141, 209], [140, 209, 208], [141, 142, 210], [141, 210, 209], [142, 143, 211], [142, 211, 210], [143, 144, 212], [143, 212, 211], [144, 145, 213], [144, 213, 212], [145, 146, 214], [145, 214, 213], [146, 147, 215], [146, 215, 214], [147, 148, 216], [147, 216, 215], [148, 149, 217], [148, 217, 216], [149, 150, 218], [149, 218, 217], [150, 151, 219], [150, 219, 218], [151, 152, 220], [151, 220, 219], [152, 153, 221], [152, 221, 220], [153, 154, 222], [153, 222, 221], [154, 155, 223], [154, 223, 222], [155, 156, 224], [155, 224, 223], [156, 157, 225], [156, 225, 224], [157, 158, 226], [157, 226, 225], [158, 159, 227], [158, 227, 226], [159, 160, 228], [159, 228, 227], [160, 161, 229], [160, 229, 228], [161, 162, 230], [161, 230, 229], [162, 163, 231], [162, 231, 230], [163, 164, 232], [163, 232, 231], [164, 165, 233], [164, 233, 232], [165, 166, 234], [165, 234, 233], [166, 167, 235], [166, 235, 234], [167, 168, 236], [167, 236, 235], [168, 169, 237], [168, 237, 236], [169, 170, 238], [169, 238, 237], [170, 171, 239], [170, 239, 238], [171, 172, 240], [171, 240, 239], [172, 173, 241], [172, 241, 240], [173, 174, 242], [173, 242, 241], [174, 175, 243], [174, 243, 242], [175, 176, 244], [175, 244, 243], [176, 177, 245], [176, 245, 244], [177, 178, 246], [177, 246, 245], [178, 179, 247], [178, 247, 246], [179, 180, 248], [179, 248, 247], [180, 181, 249], [180, 249, 248], [181, 182, 250], [181, 250, 249], [182, 183, 251], [182, 251, 250], [183, 184, 252], [183, 252, 251], [184, 185, 253], [184, 253, 252], [185, 186, 254], [185, 254, 253], [186, 187, 255], [186, 255, 254], [187, 188, 256], [187, 256, 255], [188, 189, 257], [188, 257, 256], [189, 190, 258], [189, 258, 257], [190, 191, 259], [190, 259, 258], [191, 192, 260], [191, 260, 259], [192, 193, 261], [192, 261, 260], [193, 194, 262], [193, 262, 261], [194, 195, 263], [194, 263, 262], [195, 196, 264], [195, 264, 263], [196, 197, 265], [196, 265, 264], [197, 198, 266], [197, 266, 265], [198, 199, 267], [198, 267, 266], [199, 200, 268], [199, 268, 267], [200, 201, 269], [200, 269, 268], [201, 202, 270], [201, 270, 269], [202, 203, 271], [202, 271, 270], [203, 136, 204], [203, 204, 271], [204, 205, 273], [204, 273, 272], [205, 206, 274], [205, 274, 273], [206, 207, 275], [206, 275, 274], [207, 208, 276], [207, 276, 275], [208, 209, 277], [208, 277, 276], [209, 210, 278], [209, 278, 277], [210, 211, 279], [210, 279, 278], [211, 212, 280], [211, 280, 279], [212, 213, 281], [212, 281, 280], [213, 214, 282], [213, 282, 281], [214, 215, 283], [214, 283, 282], [215, 216, 284], [215, 284, 283], [216, 217, 285], [216, 285, 284], [217, 218, 286], [217, 286, 285], [218, 219, 287], [218, 287, 286], [219, 220, 288], [219, 288, 287], [220, 221, 289], [220, 289, 288], [221, 222, 290], [221, 290, 289], [222, 223, 291], [222, 291, 290], [223, 224, 292], [223, 292, 291], [224, 225, 293], [224, 293, 292], [225, 226, 294], [225, 294, 293], [226, 227, 295], [226, 295, 294], [227, 228, 296], [227, 296, 295], [228, 229, 297], [228, 297, 296], [229, 230, 298], [229, 298, 297], [230, 231, 299], [230, 299, 298], [231, 232, 300], [231, 300, 299], [232, 233, 301], [232, 301, 300], [233, 234, 302], [233, 302, 301], [234, 235, 303], [234, 303, 302], [235, 236, 304], [235, 304, 303], [236, 237, 305], [236, 305, 304], [237, 238, 306], [237, 306, 305], [238, 239, 307], [238, 307, 306], [239, 240, 308], [239, 308, 307], [240, 241, 309], [240, 309, 308], [241, 242, 310], [241, 310, 309], [242, 243, 311], [242, 311, 310], [243, 244, 312], [243, 312, 311], [244, 245, 313], [244, 313, 312], [245, 246, 314], [245, 314, 313], [246, 247, 315], [246, 315, 314], [247, 248, 316], [247, 316, 315], [248, 249, 317], [248, 317, 316], [249, 250, 318], [249, 318, 317], [250, 251, 319], [250, 319, 318], [251, 252, 320], [251, 320, 319], [252, 253, 321], [252, 321, 320], [253, 254, 322], [253, 322, 321], [254, 255, 323], [254, 323, 322], [255, 256, 324], [255, 324, 323], [256, 257, 325], [256, 325, 324], [257, 258, 326], [257, 326, 325], [258, 259, 327], [258, 327, 326], [259, 260, 328], [259, 328, 327], [260, 261, 329], [260, 329, 328], [261, 262, 330], [261, 330, 329], [262, 263, 331], [262, 331, 330], [263, 264, 332], [263, 332, 331], [264, 265, 333], [264, 333, 332], [265, 266, 334], [265, 334, 333], [266, 267, 335], [266, 335, 334], [267, 268, 336], [267, 336, 335], [268, 269, 337], [268, 337, 336], [269, 270, 338], [269, 338, 337], [270, 271, 339], [270, 339, 338], [271, 204, 272], [271, 272, 339], [272, 273, 341], [272, 341, 340], [273, 274, 342], [273, 342, 341], [274, 275, 343], [274, 343, 342], [275, 276, 344], [275, 344, 343], [276, 277, 345], [276, 345, 344], [277, 278, 346], [277, 346, 345], [278, 279, 347], [278, 347, 346], [279, 280, 348], [279, 348, 347], [280, 281, 349], [280, 349, 348], [281, 282, 350], [281, 350, 349], [282, 283, 351], [282, 351, 350], [283, 284, 352], [283, 352, 351], [284, 285, 353], [284, 353, 352], [285, 286, 354], [285, 354, 353], [286, 287, 355], [286, 355, 354], [287, 288, 356], [287, 356, 355], [288, 289, 357], [288, 357, 356], [289, 290, 358], [289, 358, 357], [290, 291, 359], [290, 359, 358], [291, 292, 360], [291, 360, 359], [292, 293, 361], [292, 361, 360], [293, 294, 362], [293, 362, 361], [294, 295, 363], [294, 363, 362], [295, 296, 364], [295, 364, 363], [296, 297, 365], [296, 365, 364], [297, 298, 366], [297, 366, 365], [298, 299, 367], [298, 367, 366], [299, 300, 368], [299, 368, 367], [300, 301, 369], [300, 369, 368], [301, 302, 370], [301, 370, 369], [302, 303, 371], [302, 371, 370], [303, 304, 372], [303, 372, 371], [304, 305, 373], [304, 373, 372], [305, 306, 374], [305, 374, 373], [306, 307, 375], [306, 375, 374], [307, 308, 376], [307, 376, 375], [308, 309, 377], [308, 377, 376], [309, 310, 378], [309, 378, 377], [310, 311, 379], [310, 379, 378], [311, 312, 380], [311, 380, 379], [312, 313, 381], [312, 381, 380], [313, 314, 382], [313, 382, 381], [314, 315, 383], [314, 383, 382], [315, 316, 384], [315, 384, 383], [316, 317, 385], [316, 385, 384], [317, 318, 386], [317, 386, 385], [318, 319, 387], [318, 387, 386], [319, 320, 388], [319, 388, 387], [320, 321, 389], [320, 389, 388], [321, 322, 390], [321, 390, 389], [322, 323, 391], [322, 391, 390], [323, 324, 392], [323, 392, 391], [324, 325, 393], [324, 393, 392], [325, 326, 394], [325, 394, 393], [326, 327, 395], [326, 395, 394], [327, 328, 396], [327, 396, 395], [328, 329, 397], [328, 397, 396], [329, 330, 398], [329, 398, 397], [330, 331, 399], [330, 399, 398], [331, 332, 400], [331, 400, 399], [332, 333, 401], [332, 401, 400], [333, 334, 402], [333, 402, 401], [334, 335, 403], [334, 403, 402], [335, 336, 404], [335, 404, 403], [336, 337, 405], [336, 405, 404], [337, 338, 406], [337, 406, 405], [338, 339, 407], [338, 407, 406], [339, 272, 340], [339, 340, 407], [340, 341, 409], [340, 409, 408], [341, 342, 410], [341, 410, 409], [342, 343, 411], [342, 411, 410], [343, 344, 412], [343, 412, 411], [344, 345, 413], [344, 413, 412], [345, 346, 414], [345, 414, 413], [346, 347, 415], [346, 415, 414], [347, 348, 416], [347, 416, 415], [348, 349, 417], [348, 417, 416], [349, 350, 418], [349, 418, 417], [350, 351, 419], [350, 419, 418], [351, 352, 420], [351, 420, 419], [352, 353, 421], [352, 421, 420], [353, 354, 422], [353, 422, 421], [354, 355, 423], [354, 423, 422], [355, 356, 424], [355, 424, 423], [356, 357, 425], [356, 425, 424], [357, 358, 426], [357, 426, 425], [358, 359, 427], [358, 427, 426], [359, 360, 428], [359, 428, 427], [360, 361, 429], [360, 429, 428], [361, 362, 430], [361, 430, 429], [362, 363, 431], [362, 431, 430], [363, 364, 432], [363, 432, 431], [364, 365, 433], [364, 433, 432], [365, 366, 434], [365, 434, 433], [366, 367, 435], [366, 435, 434], [367, 368, 436], [367, 436, 435], [368, 369, 437], [368, 437, 436], [369, 370, 438], [369, 438, 437], [370, 371, 439], [370, 439, 438], [371, 372, 440], [371, 440, 439], [372, 373, 441], [372, 441, 440], [373, 374, 442], [373, 442, 441], [374, 375, 443], [374, 443, 442], [375, 376, 444], [375, 444, 443], [376, 377, 445], [376, 445, 444], [377, 378, 446], [377, 446, 445], [378, 379, 447], [378, 447, 446], [379, 380, 448], [379, 448, 447], [380, 381, 449], [380, 449, 448], [381, 382, 450], [381, 450, 449], [382, 383, 451], [382, 451, 450], [383, 384, 452], [383, 452, 451], [384, 385, 453], [384, 453, 452], [385, 386, 454], [385, 454, 453], [386, 387, 455], [386, 455, 454], [387, 388, 456], [387, 456, 455], [388, 389, 457], [388, 457, 456], [389, 390, 458], [389, 458, 457], [390, 391, 459], [390, 459, 458], [391, 392, 460], [391, 460, 459], [392, 393, 461], [392, 461, 460], [393, 394, 462], [393, 462, 461], [394, 395, 463], [394, 463, 462], [395, 396, 464], [395, 464, 463], [396, 397, 465], [396, 465, 464], [397, 398, 466], [397, 466, 465], [398, 399, 467], [398, 467, 466], [399, 400, 468], [399, 468, 467], [400, 401, 469], [400, 469, 468], [401, 402, 470], [401, 470, 469], [402, 403, 471], [402, 471, 470], [403, 404, 472], [403, 472, 471], [404, 405, 473], [404, 473, 472], [405, 406, 474], [405, 474, 473], [406, 407, 475], [406, 475, 474], [407, 340, 408], [407, 408, 475], [408, 409, 477], [408, 477, 476], [409, 410, 478], [409, 478, 477], [410, 411, 479], [410, 479, 478], [411, 412, 480], [411, 480, 479], [412, 413, 481], [412, 481, 480], [413, 414, 482], [413, 482, 481], [414, 415, 483], [414, 483, 482], [415, 416, 484], [415, 484, 483], [416, 417, 485], [416, 485, 484], [417, 418, 486], [417, 486, 485], [418, 419, 487], [418, 487, 486], [419, 420, 488], [419, 488, 487], [420, 421, 489], [420, 489, 488], [421, 422, 490], [421, 490, 489], [422, 423, 491], [422, 491, 490], [423, 424, 492], [423, 492, 491], [424, 425, 493], [424, 493, 492], [425, 426, 494], [425, 494, 493], [426, 427, 495], [426, 495, 494], [427, 428, 496], [427, 496, 495], [428, 429, 497], [428, 497, 496], [429, 430, 498], [429, 498, 497], [430, 431, 499], [430, 499, 498], [431, 432, 500], [431, 500, 499], [432, 433, 501], [432, 501, 500], [433, 434, 502], [433, 502, 501], [434, 435, 503], [434, 503, 502], [435, 436, 504], [435, 504, 503], [436, 437, 505], [436, 505, 504], [437, 438, 506], [437, 506, 505], [438, 439, 507], [438, 507, 506], [439, 440, 508], [439, 508, 507], [440, 441, 509], [440, 509, 508], [441, 442, 510], [441, 510, 509], [442, 443, 511], [442, 511, 510], [443, 444, 512], [443, 512, 511], [444, 445, 513], [444, 513, 512], [445, 446, 514], [445, 514, 513], [446, 447, 515], [446, 515, 514], [447, 448, 516], [447, 516, 515], [448, 449, 517], [448, 517, 516], [449, 450, 518], [449, 518, 517], [450, 451, 519], [450, 519, 518], [451, 452, 520], [451, 520, 519], [452, 453, 521], [452, 521, 520], [453, 454, 522], [453, 522, 521], [454, 455, 523], [454, 523, 522], [455, 456, 524], [455, 524, 523], [456, 457, 525], [456, 525, 524], [457, 458, 526], [457, 526, 525], [458, 459, 527], [458, 527, 526], [459, 460, 528], [459, 528, 527], [460, 461, 529], [460, 529, 528], [461, 462, 530], [461, 530, 529], [462, 463, 531], [462, 531, 530], [463, 464, 532], [463, 532, 531], [464, 465, 533], [464, 533, 532], [465, 466, 534], [465, 534, 533], [466, 467, 535], [466, 535, 534], [467, 468, 536], [467, 536, 535], [468, 469, 537], [468, 537, 536], [469, 470, 538], [469, 538, 537], [470, 471, 539], [470, 539, 538], [471, 472, 540], [471, 540, 539], [472, 473, 541], [472, 541, 540], [473, 474, 542], [473, 542, 541], [474, 475, 543], [474, 543, 542], [475, 408, 476], [475, 476, 543], [476, 477, 545], [476, 545, 544], [477, 478, 546], [477, 546, 545], [478, 479, 547], [478, 547, 546], [479, 480, 548], [479, 548, 547], [480, 481, 549], [480, 549, 548], [481, 482, 550], [481, 550, 549], [482, 483, 551], [482, 551, 550], [483, 484, 552], [483, 552, 551], [484, 485, 553], [484, 553, 552], [485, 486, 554], [485, 554, 553], [486, 487, 555], [486, 555, 554], [487, 488, 556], [487, 556, 555], [488, 489, 557], [488, 557, 556], [489, 490, 558], [489, 558, 557], [490, 491, 559], [490, 559, 558], [491, 492, 560], [491, 560, 559], [492, 493, 561], [492, 561, 560], [493, 494, 562], [493, 562, 561], [494, 495, 563], [494, 563, 562], [495, 496, 564], [495, 564, 563], [496, 497, 565], [496, 565, 564], [497, 498, 566], [497, 566, 565], [498, 499, 567], [498, 567, 566], [499, 500, 568], [499, 568, 567], [500, 501, 569], [500, 569, 568], [501, 502, 570], [501, 570, 569], [502, 503, 571], [502, 571, 570], [503, 504, 572], [503, 572, 571], [504, 505, 573], [504, 573, 572], [505, 506, 574], [505, 574, 573], [506, 507, 575], [506, 575, 574], [507, 508, 576], [507, 576, 575], [508, 509, 577], [508, 577, 576], [509, 510, 578], [509, 578, 577], [510, 511, 579], [510, 579, 578], [511, 512, 580], [511, 580, 579], [512, 513, 581], [512, 581, 580], [513, 514, 582], [513, 582, 581], [514, 515, 583], [514, 583, 582], [515, 516, 584], [515, 584, 583], [516, 517, 585], [516, 585, 584], [517, 518, 586], [517, 586, 585], [518, 519, 587], [518, 587, 586], [519, 520, 588], [519, 588, 587], [520, 521, 589], [520, 589, 588], [521, 522, 590], [521, 590, 589], [522, 523, 591], [522, 591, 590], [523, 524, 592], [523, 592, 591], [524, 525, 593], [524, 593, 592], [525, 526, 594], [525, 594, 593], [526, 527, 595], [526, 595, 594], [527, 528, 596], [527, 596, 595], [528, 529, 597], [528, 597, 596], [529, 530, 598], [529, 598, 597], [530, 531, 599], [530, 599, 598], [531, 532, 600], [531, 600, 599], [532, 533, 601], [532, 601, 600], [533, 534, 602], [533, 602, 601], [534, 535, 603], [534, 603, 602], [535, 536, 604], [535, 604, 603], [536, 537, 605], [536, 605, 604], [537, 538, 606], [537, 606, 605], [538, 539, 607], [538, 607, 606], [539, 540, 608], [539, 608, 607], [540, 541, 609], [540, 609, 608], [541, 542, 610], [541, 610, 609], [542, 543, 611], [542, 611, 610], [543, 476, 544], [543, 544, 611], [544, 545, 613], [544, 613, 612], [545, 546, 614], [545, 614, 613], [546, 547, 615], [546, 615, 614], [547, 548, 616], [547, 616, 615], [548, 549, 617], [548, 617, 616], [549, 550, 618], [549, 618, 617], [550, 551, 619], [550, 619, 618], [551, 552, 620], [551, 620, 619], [552, 553, 621], [552, 621, 620], [553, 554, 622], [553, 622, 621], [554, 555, 623], [554, 623, 622], [555, 556, 624], [555, 624, 623], [556, 557, 625], [556, 625, 624], [557, 558, 626], [557, 626, 625], [558, 559, 627], [558, 627, 626], [559, 560, 628], [559, 628, 627], [560, 561, 629], [560, 629, 628], [561, 562, 630], [561, 630, 629], [562, 563, 631], [562, 631, 630], [563, 564, 632], [563, 632, 631], [564, 565, 633], [564, 633, 632], [565, 566, 634], [565, 634, 633], [566, 567, 635], [566, 635, 634], [567, 568, 636], [567, 636, 635], [568, 569, 637], [568, 637, 636], [569, 570, 638], [569, 638, 637], [570, 571, 639], [570, 639, 638], [571, 572, 640], [571, 640, 639], [572, 573, 641], [572, 641, 640], [573, 574, 642], [573, 642, 641], [574, 575, 643], [574, 643, 642], [575, 576, 644], [575, 644, 643], [576, 577, 645], [576, 645, 644], [577, 578, 646], [577, 646, 645], [578, 579, 647], [578, 647, 646], [579, 580, 648], [579, 648, 647], [580, 581, 649], [580, 649, 648], [581, 582, 650], [581, 650, 649], [582, 583, 651], [582, 651, 650], [583, 584, 652], [583, 652, 651], [584, 585, 653], [584, 653, 652], [585, 586, 654], [585, 654, 653], [586, 587, 655], [586, 655, 654], [587, 588, 656], [587, 656, 655], [588, 589, 657], [588, 657, 656], [589, 590, 658], [589, 658, 657], [590, 591, 659], [590, 659, 658], [591, 592, 660], [591, 660, 659], [592, 593, 661], [592, 661, 660], [593, 594, 662], [593, 662, 661], [594, 595, 663], [594, 663, 662], [595, 596, 664], [595, 664, 663], [596, 597, 665], [596, 665, 664], [597, 598, 666], [597, 666, 665], [598, 599, 667], [598, 667, 666], [599, 600, 668], [599, 668, 667], [600, 601, 669], [600, 669, 668], [601, 602, 670], [601, 670, 669], [602, 603, 671], [602, 671, 670], [603, 604, 672], [603, 672, 671], [604, 605, 673], [604, 673, 672], [605, 606, 674], [605, 674, 673], [606, 607, 675], [606, 675, 674], [607, 608, 676], [607, 676, 675], [608, 609, 677], [608, 677, 676], [609, 610, 678], [609, 678, 677], [610, 611, 679], [610, 679, 678], [611, 544, 612], [611, 612, 679], [612, 613, 681], [612, 681, 680], [613, 614, 682], [613, 682, 681], [614, 615, 683], [614, 683, 682], [615, 616, 684], [615, 684, 683], [616, 617, 685], [616, 685, 684], [617, 618, 686], [617, 686, 685], [618, 619, 687], [618, 687, 686], [619, 620, 688], [619, 688, 687], [620, 621, 689], [620, 689, 688], [621, 622, 690], [621, 690, 689], [622, 623, 691], [622, 691, 690], [623, 624, 692], [623, 692, 691], [624, 625, 693], [624, 693, 692], [625, 626, 694], [625, 694, 693], [626, 627, 695], [626, 695, 694], [627, 628, 696], [627, 696, 695], [628, 629, 697], [628, 697, 696], [629, 630, 698], [629, 698, 697], [630, 631, 699], [630, 699, 698], [631, 632, 700], [631, 700, 699], [632, 633, 701], [632, 701, 700], [633, 634, 702], [633, 702, 701], [634, 635, 703], [634, 703, 702], [635, 636, 704], [635, 704, 703], [636, 637, 705], [636, 705, 704], [637, 638, 706], [637, 706, 705], [638, 639, 707], [638, 707, 706], [639, 640, 708], [639, 708, 707], [640, 641, 709], [640, 709, 708], [641, 642, 710], [641, 710, 709], [642, 643, 711], [642, 711, 710], [643, 644, 712], [643, 712, 711], [644, 645, 713], [644, 713, 712], [645, 646, 714], [645, 714, 713], [646, 647, 715], [646, 715, 714], [647, 648, 716], [647, 716, 715], [648, 649, 717], [648, 717, 716], [649, 650, 718], [649, 718, 717], [650, 651, 719], [650, 719, 718], [651, 652, 720], [651, 720, 719], [652, 653, 721], [652, 721, 720], [653, 654, 722], [653, 722, 721], [654, 655, 723], [654, 723, 722], [655, 656, 724], [655, 724, 723], [656, 657, 725], [656, 725, 724], [657, 658, 726], [657, 726, 725], [658, 659, 727], [658, 727, 726], [659, 660, 728], [659, 728, 727], [660, 661, 729], [660, 729, 728], [661, 662, 730], [661, 730, 729], [662, 663, 731], [662, 731, 730], [663, 664, 732], [663, 732, 731], [664, 665, 733], [664, 733, 732], [665, 666, 734], [665, 734, 733], [666, 667, 735], [666, 735, 734], [667, 668, 736], [667, 736, 735], [668, 669, 737], [668, 737, 736], [669, 670, 738], [669, 738, 737], [670, 671, 739], [670, 739, 738], [671, 672, 740], [671, 740, 739], [672, 673, 741], [672, 741, 740], [673, 674, 742], [673, 742, 741], [674, 675, 743], [674, 743, 742], [675, 676, 744], [675, 744, 743], [676, 677, 745], [676, 745, 744], [677, 678, 746], [677, 746, 745], [678, 679, 747], [678, 747, 746], [679, 612, 680], [679, 680, 747], [680, 681, 749], [680, 749, 748], [681, 682, 750], [681, 750, 749], [682, 683, 751], [682, 751, 750], [683, 684, 752], [683, 752, 751], [684, 685, 753], [684, 753, 752], [685, 686, 754], [685, 754, 753], [686, 687, 755], [686, 755, 754], [687, 688, 756], [687, 756, 755], [688, 689, 757], [688, 757, 756], [689, 690, 758], [689, 758, 757], [690, 691, 759], [690, 759, 758], [691, 692, 760], [691, 760, 759], [692, 693, 761], [692, 761, 760], [693, 694, 762], [693, 762, 761], [694, 695, 763], [694, 763, 762], [695, 696, 764], [695, 764, 763], [696, 697, 765], [696, 765, 764], [697, 698, 766], [697, 766, 765], [698, 699, 767], [698, 767, 766], [699, 700, 768], [699, 768, 767], [700, 701, 769], [700, 769, 768], [701, 702, 770], [701, 770, 769], [702, 703, 771], [702, 771, 770], [703, 704, 772], [703, 772, 771], [704, 705, 773], [704, 773, 772], [705, 706, 774], [705, 774, 773], [706, 707, 775], [706, 775, 774], [707, 708, 776], [707, 776, 775], [708, 709, 777], [708, 777, 776], [709, 710, 778], [709, 778, 777], [710, 711, 779], [710, 779, 778], [711, 712, 780], [711, 780, 779], [712, 713, 781], [712, 781, 780], [713, 714, 782], [713, 782, 781], [714, 715, 783], [714, 783, 782], [715, 716, 784], [715, 784, 783], [716, 717, 785], [716, 785, 784], [717, 718, 786], [717, 786, 785], [718, 719, 787], [718, 787, 786], [719, 720, 788], [719, 788, 787], [720, 721, 789], [720, 789, 788], [721, 722, 790], [721, 790, 789], [722, 723, 791], [722, 791, 790], [723, 724, 792], [723, 792, 791], [724, 725, 793], [724, 793, 792], [725, 726, 794], [725, 794, 793], [726, 727, 795], [726, 795, 794], [727, 728, 796], [727, 796, 795], [728, 729, 797], [728, 797, 796], [729, 730, 798], [729, 798, 797], [730, 731, 799], [730, 799, 798], [731, 732, 800], [731, 800, 799], [732, 733, 801], [732, 801, 800], [733, 734, 802], [733, 802, 801], [734, 735, 803], [734, 803, 802], [735, 736, 804], [735, 804, 803], [736, 737, 805], [736, 805, 804], [737, 738, 806], [737, 806, 805], [738, 739, 807], [738, 807, 806], [739, 740, 808], [739, 808, 807], [740, 741, 809], [740, 809, 808], [741, 742, 810], [741, 810, 809], [742, 743, 811], [742, 811, 810], [743, 744, 812], [743, 812, 811], [744, 745, 813], [744, 813, 812], [745, 746, 814], [745, 814, 813], [746, 747, 815], [746, 815, 814], [747, 680, 748], [747, 748, 815], [748, 749, 817], [748, 817, 816], [749, 750, 818], [749, 818, 817], [750, 751, 819], [750, 819, 818], [751, 752, 820], [751, 820, 819], [752, 753, 821], [752, 821, 820], [753, 754, 822], [753, 822, 821], [754, 755, 823], [754, 823, 822], [755, 756, 824], [755, 824, 823], [756, 757, 825], [756, 825, 824], [757, 758, 826], [757, 826, 825], [758, 759, 827], [758, 827, 826], [759, 760, 828], [759, 828, 827], [760, 761, 829], [760, 829, 828], [761, 762, 830], [761, 830, 829], [762, 763, 831], [762, 831, 830], [763, 764, 832], [763, 832, 831], [764, 765, 833], [764, 833, 832], [765, 766, 834], [765, 834, 833],
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
