sturivny/co2_temperature_sensor_mac/enclosure/v0.9/fit_esp32_snaps.scad

// Sample with flexible side latches, v0.9. Millimetres.
translate([-40.2, -7.0, 0]) union(){
difference(){
translate([40.2, 7.0, 0]) cube([37.8, 24.6, 2.0]);
translate([56.2, 6.9, -0.1]) cube([10.6, 2.3, 2.2]);
translate([56.2, 29.400000000000002, -0.1]) cube([10.6, 2.3, 2.2]);
}
union(){
translate([53.2, 7.2, 2.0]) cube([2.0, 2.6, 3.0]);
translate([53.2, 7.2, 2.0]) cube([2.0, 1.5, 4.8]);
translate([53.2, 28.8, 2.0]) cube([2.0, 2.6, 3.0]);
translate([53.2, 29.900000000000002, 2.0]) cube([2.0, 1.5, 4.8]);
translate([72.0, 7.2, 2.0]) cube([2.0, 2.6, 3.0]);
translate([72.0, 7.2, 2.0]) cube([2.0, 1.5, 4.8]);
translate([72.0, 28.8, 2.0]) cube([2.0, 2.6, 3.0]);
translate([72.0, 29.900000000000002, 2.0]) cube([2.0, 1.5, 4.8]);
translate([47.85, 15.3, 2.0]) cube([3.2, 8.0, 4.8]);
translate([41.050000000000004, 14.3, 1.5]) cube([10.0, 10.0, 1.1]);
polyhedron(points=[[41.85, 15.5, 2.0], [48.15, 15.5, 2.0], [48.15, 15.5, 6.8], [41.85, 17.3, 2.0], [48.15, 17.3, 2.0], [48.15, 17.3, 6.8]],faces=[[1, 2, 0], [5, 4, 3], [4, 1, 0], [3, 4, 0], [5, 2, 1], [4, 5, 1], [3, 0, 2], [5, 3, 2]]);
polyhedron(points=[[41.85, 21.3, 2.0], [48.15, 21.3, 2.0], [48.15, 21.3, 6.8], [41.85, 23.1, 2.0], [48.15, 23.1, 2.0], [48.15, 23.1, 6.8]],faces=[[1, 2, 0], [5, 4, 3], [4, 1, 0], [3, 4, 0], [5, 2, 1], [4, 5, 1], [3, 0, 2], [5, 3, 2]]);
}
union(){
translate([54.2, 7.8999999999999995, 0]) cube([12.0, 0.8, 8.0]);
polyhedron(points=[[63.800000000000004, 9.35, 6.75], [66.2, 9.35, 6.75], [63.800000000000004, 8.649999999999999, 6.75], [66.2, 8.649999999999999, 6.75], [63.800000000000004, 8.649999999999999, 8.0], [66.2, 8.649999999999999, 8.0]],faces=[[0, 2, 4], [1, 5, 3], [0, 1, 3], [0, 3, 2], [2, 3, 5], [2, 5, 4], [4, 5, 1], [4, 1, 0]]);
translate([63.800000000000004, 7.3, 7.2]) cube([2.4, 0.65, 0.8]);
}
union(){
translate([54.2, 29.900000000000002, 0]) cube([12.0, 0.8, 8.0]);
polyhedron(points=[[63.800000000000004, 29.25, 6.75], [66.2, 29.25, 6.75], [63.800000000000004, 29.950000000000003, 6.75], [66.2, 29.950000000000003, 6.75], [63.800000000000004, 29.950000000000003, 8.0], [66.2, 29.950000000000003, 8.0]],faces=[[4, 2, 0], [3, 5, 1], [3, 1, 0], [2, 3, 0], [5, 3, 2], [4, 5, 2], [1, 5, 4], [0, 1, 4]]);
translate([63.800000000000004, 30.650000000000002, 7.2]) cube([2.4, 0.65, 0.8]);
}
difference(){
translate([76.0, 7.0, 0]) cube([2, 24.6, 15.0]);
union(){
translate([75.9, 16.3, 5.8]) cube([2.2, 6.0, 3.6]);
translate([75.9, 16.3, 7.6]) rotate([0,90,0]) cylinder(h=2.2,r=1.8,$fn=128);
translate([75.9, 22.3, 7.6]) rotate([0,90,0]) cylinder(h=2.2,r=1.8,$fn=128);
}
}
}
