sturivny/co2_temperature_sensor_mac/(list of files, cad)

Other CAD files:
enclosure/v0.8/lid.stl
enclosure/v0.8/base.stl
enclosure/v0.8/screw_test_cap.stl
enclosure/v0.8/enclosure.scad
enclosure/v0.8/fit_esp32_snaps.scad
enclosure/v0.8/fit_sensor_snaps.scad
enclosure/v0.8/screw_test.scad
