sturivny/co2_temperature_sensor_mac/docs/ru/VALIDATION.md

# Проверка 16 октября 2026

- Прошивка собрана: ESP32-C3, 4 MiB flash, Arduino ESP32 2.0.17, PlatformIO espressif32 6.12.0.
- Перед первой загрузкой сохранена заводская flash (4 MiB), локально в `.tooling/backup`.
- Запись прошивки на реальную плату завершилась проверкой хешей.
- Реальный датчик отвечает на 0x62, OLED найден сканированием на 0x3C, шина GPIO5/6.
- Получены реальные CO₂, температура, влажность; например 418 ppm / 25,18 °C / 41,54 %.
  Это проверка получения данных, не метрологическая проверка точности датчика.
- Журнал реальной платы сообщил healthy=true, capacity=32768; первую запись удалось
  прочитать и сохранить нативным транспортом приложения Mac (`--usb-check`).
- Хостовые тесты C++: эталоны CRC датчика и журнала, 32 позиции обрыва записи,
  1800 записей с кольцевым переполнением, восстановление после перезапуска,
  пагинация, повреждение записи — PASS.
- Нативное приложение Swift: компиляция, локальная подпись, тест SQLite,
  повторный импорт без дубликатов, восстановление времени, учёт пропусков,
  CSV — PASS. USB-чтение статуса и журнала реальной платы — PASS.
- Для запуска после прошивки этой платы требуется ручное нажатие RST.
- Прошивка 0.1.1 исправляет восстановление аппаратной I²C-шины после настройки
  контактов библиотекой U8g2. После обновления одновременно sensor_started=true,
  oled_found=true, error пустой; журнал сохранился и вырос с 1 до 2 записей.
- Пользователь подтвердил: цифры на OLED видны. Автоматический перезапуск через
  watchdog после загрузки последней версии также прошёл успешно.
- Wi-Fi настроен: подтверждено подключение к домашней сети. С Mac по mDNS
  успешно прочитаны авторизованные /api/status и /api/history; реальные
  показания и история получены через сеть. unix_s заполнен.
- Работа с конкретным power bank после отключения USB от Mac ещё не проверена.

## Перенос в репозиторий

Проверено из нового checkout 16 октября 2026:

- `tools/check.py`: синтаксис Python, C++-тесты журнала, сборка и локальная
  подпись приложения Mac, SQLite/CSV self-test — PASS.
- Сборка прошивки с закреплёнными зависимостями — PASS (RAM 42436 байт,
  Flash 857652 байта по отчёту PlatformIO).
- `check_mount.py` и `check_usb_profile.py` — PASS. Проверка креплений больше
  не требует соседней папки v0.7; сохранены контрольные суммы примеренного датчика.
- Ссылки между локальными документами проверены.
- Известные ключи доступа, пароль Wi-Fi, настройки Mac, SQLite-история и заводская
  flash не входят в публикуемые файлы. Выполнена проверка состава и известных
  секретов без вывода их значений.
- Во время переноса устройство повторно не прошивалось. Данные о работе платы
  выше относятся к выполненным ранее реальным аппаратным проверкам.

## Корпус v0.9 — 27 октября 2026

По сообщению пользователя после использования сломался задний осевой упор
контроллера. Добавлены широкая стенка, площадка в основании и два ребра.
Посадка платы сохранена. Проводной паз шириной 8 мм открыт сверху.
Крышка и проба винта — с прямыми отверстиями Ø2,4 мм и плоской посадкой
под головки M2 с внутренним шестигранником; длина M2×10 считается из-под головки.

Три генератора и проверки креплений, USB, усиления, плоской посадки и проводного
паза прошли. Восемь STL — замкнутые сетки, согласованные грани, одно тело.
Посадка и установка плат, снятие крышки и принятые габариты компонентов проверены.
Образцы датчика и положение USB сохранены. Из основания удалён материал только
в новом пазу. Превью просмотрены. Версия v0.8 сохранена. Реальная прочность,
ресурс, резьба и установка проводов в v0.9 пока требуют пробной печати.
Устройство не перепрошивалось.

## Температурные графики — 28 октября 2026

Приложение 0.2.0 добавляет температуру за 7 и 24 дня из существующего архива,
сохраняя графики CO₂. Сборка, подпись и тесты прошли; проверены выбор колонки,
периоды, отсечение будущих/старых записей, отрицательные и постоянные значения.
Графики отрисованы на временной копии реальной истории, график за 24 дня
просмотрен. Личные данные и изображения не входят в Git.
Запущенное приложение заменено на 0.2.0 и перезапущено после резервного
копирования; архив сохранён без миграции. Проверки корпуса v0.9 повторно прошли;
реальная прочность пока требует пробной печати.

## Исправление периода — 0.2.1, 28 октября 2026

Пользователь уточнил: нужны последние **24 часа**, а не 24 дня. Теперь у
температуры те же периоды, что у CO₂: 24 часа и 7 дней. Запись о 0.2.0 выше
оставлена как история проверки. Тесты различают записи за шесть часов и
шесть дней, исключают данные старше недели и будущие записи. Сборка и тесты прошли.

## Восстановление связи — 2 ноября 2026

При работающем OLED и Wi-Fi-соединении HTTP не отвечал; после перезапуска при
переносе на USB HTTP восстановился. В 0.1.1 сервисы запускались один раз.
Прошивка 0.1.2 перезапускает HTTP/mDNS при переподключении Wi-Fi или смене IP.
Полная flash сохранена локально; прошита только область приложения. Проверка
записи прошла, ошибка очистки USB после watchdog-reset проверена чтением версии.
История и настройки сохранены. Три принудительных переподключения без перезапуска
контроллера прошли: статус и история снова доступны по Wi-Fi/mDNS, журнал исправен.
Приложение 0.2.2 ограничивает сетевые ожидания, показывает свежий статус независимо
от ошибки архива и позволяет смотреть сохранённые графики без устройства.
Сборки, тесты и нативная Wi-Fi-проверка прошли. Долговременная стабильность
радиосвязи и время работы конкретного power bank пока не подтверждены.

Пользователь подтвердил обновление показаний на Mac после возврата к питанию
от зарядки/power bank. Нативная Wi-Fi-проверка после этого повторно прошла.

## Экран и английский интерфейс — 2 ноября 2026

Приложение 0.3.0 переведено на английский: меню, окна, графики, ошибки,
метаданные и настройка Wi-Fi. Сборка и тесты прошли, история сохранена.
В прошивке 0.1.4 влажность крупно сверху, температура крупно посередине,
CO₂ меньшим шрифтом снизу. Границы значений проверены реальными шрифтами
U8g2, отрисован буфер 72×40. Пользователь подтвердил первоначальный размер
шрифтов, затем попросил поменять местами влажность и CO₂; окончательный
порядок учтён отдельно от первоначального подтверждения.

Итоговая прошивка 0.1.4 проверена после записи, журнал исправен и последовательность
сохранена. Wi-Fi-статус и история снова проверены; приложение 0.3.0 перезапущено.

### Окончательный единый шрифт — 0.1.5

После уточнения все три показания используют одинаковый шрифт 6×12:
влажность сверху, температура посередине, CO₂ снизу. Это заменяет предыдущие
варианты с разным размером. Границы шрифта и превью проверены повторно,
прошивка записана и проверена, версия 0.1.5 прочитана с устройства, журнал
сохранён. Wi-Fi-статус и история доступны, английское приложение перезапущено.
