sturivny/co2_temperature_sensor_mac/(commit log)

2026-10-16 Add CO2 monitor firmware, Mac app, printable enclosure and documentation
    [base.stl, enclosure.scad, fit_esp32.stl, fit_esp32_snaps.scad, fit_esp32_snaps.stl, fit_sensor.stl, fit_sensor_snaps.scad, fit_sensor_snaps.stl]
2026-10-16 Clarify Python version required for CAD dependencies
2026-10-28 Add temperature history charts and reinforced enclosure v0.9
    [base.stl, enclosure.scad, fit_esp32.stl, fit_esp32_snaps.scad, fit_esp32_snaps.stl, fit_sensor.stl, fit_sensor_snaps.scad, fit_sensor_snaps.stl]
2026-10-28 Correct temperature chart period to 24 hours
    [build_macos.py]
